thapala2301/SummerProjectMathsAccelerator/misc/Report_Sources/chapters/OrigSta_Copyright.tex

%%%%%%%%%%%%%%%%%%%%%%%%%%%%%%%%%%%%%%%
% DO NOT MODIFY FROM HERE ...
\clearpage\phantomsection
\addcontentsline{toc}{chapter}{Declaration of Originality}\mtcaddchapter 
\chapter*{Declaration of Originality}
\addtocounter{counter}{-1}
% ... TO HERE
%%%%%%%%%%%%%%%%%%%%%%%%%%%%%%%%%%%%%%%

% EDIT FROM HERE
% Example text

We hereby declare that the work presented in this lab report is our own unless otherwise stated. To the best of our knowledge the work is original and ideas developed in collaboration with others have been appropriately referenced.

\vspace{\fill} % Dynamically pushes the image block to the very bottom of the page

\begin{center}
    \vspace{-10pt} % Pulls the image box up closer to the text to save space
    
    % Shrunk to 0.48 of text width so it is guaranteed to fit on this page
    
    
    \vspace{-5pt} % Keeps the caption close to the rotated image border
    \small
    \color{gray}
    Figure 1.1: Complete real-time user interface operating on the display.
\end{center}
