thapala2301/SummerProjectMathsAccelerator/misc/Mandelbox Math.pptx

## Mandelbox Math

Dk why I made this into a presentation lmao

## Slide 2

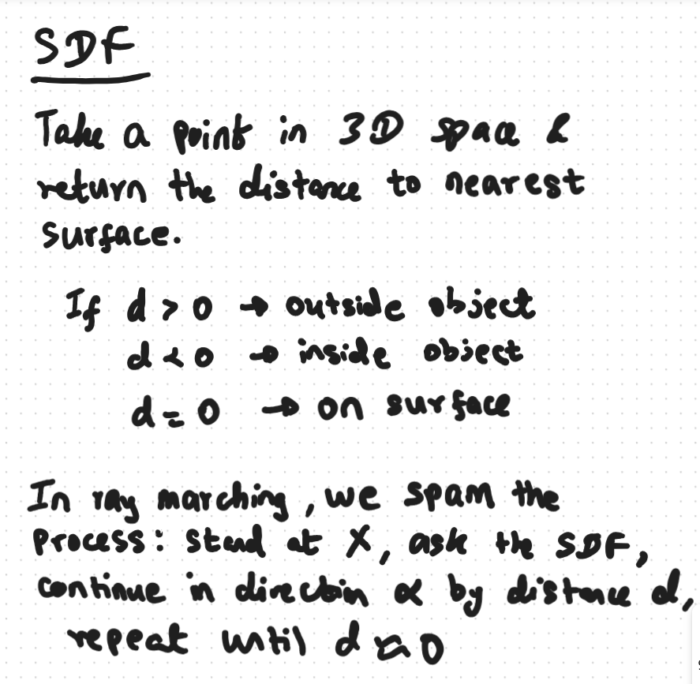
[picture p52: figure]

Example:
So like, let`s say we are looking through a pixel Y and there is a box point 10 metres ahead. There is also a box point 3 metres to the left. The distance function would say: 3 metres because that is the nearest surface in any direction. So, we would jump 3 metres in our predetermined direction and then ask again till we hit something or accept the miss after N iterations or sumn.

## Slide 3

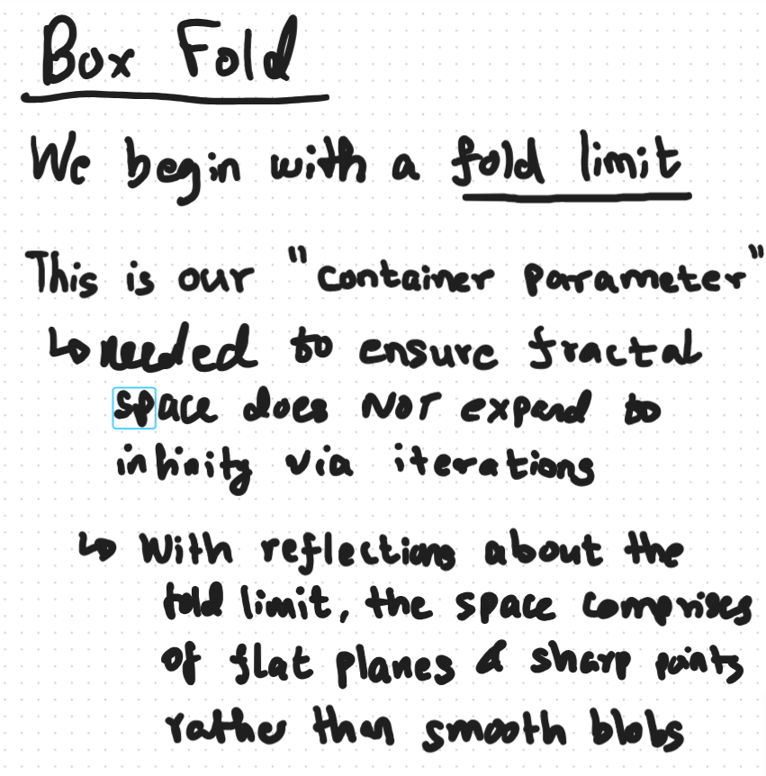
[picture p53: figure]
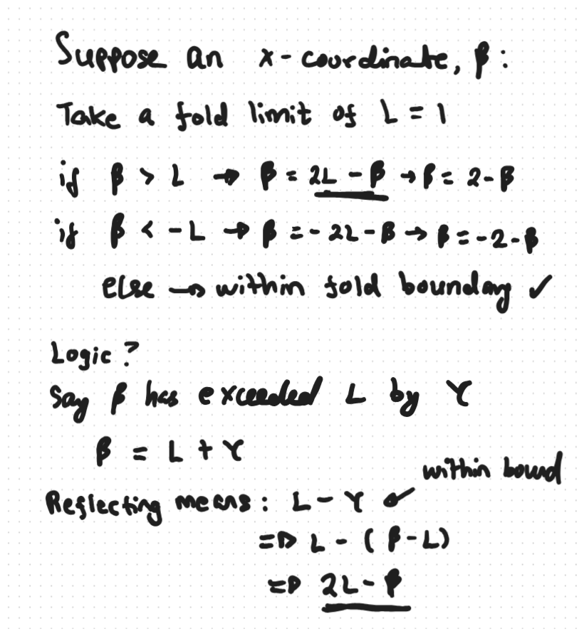
[picture p54: figure]

## Slide 4

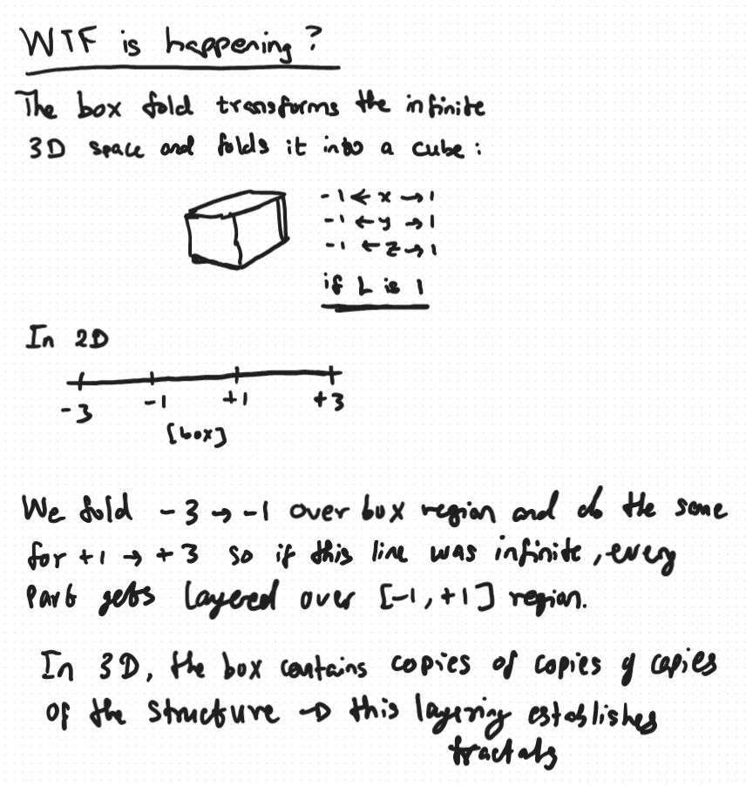
[picture p55: figure]
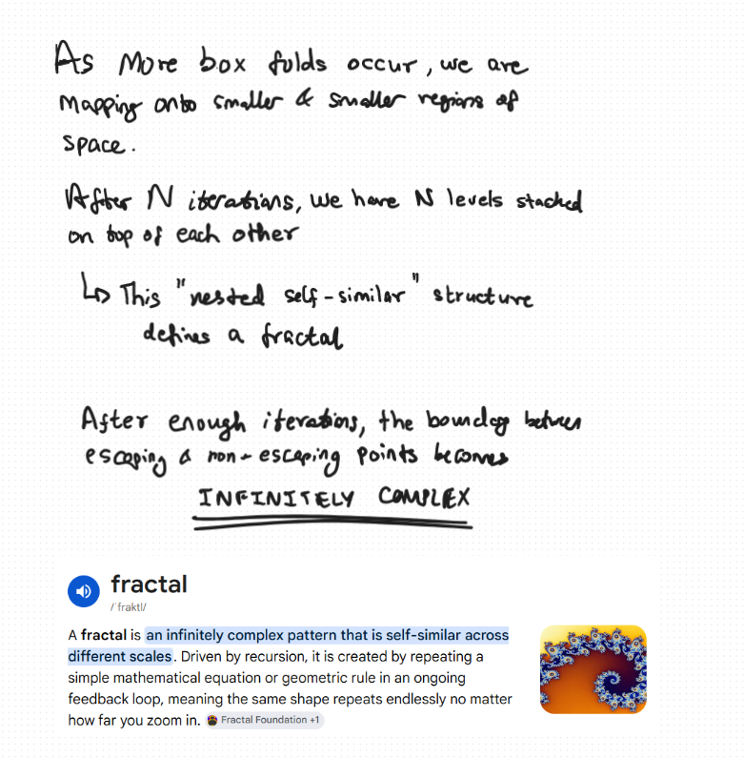
[picture p56: figure]

## Example

p = (1.7, -1.3, 0.5)
x: 1.7 > 1 → x = 2 - 1.7 = 0.3
y: -1.3 < -1 → y = -2 - (-1.3) = -2 + 1.3 = -0.7
z: in range → z = 0.5
after box fold: p = (0.3, -0.7, 0.5)

## Slide 6

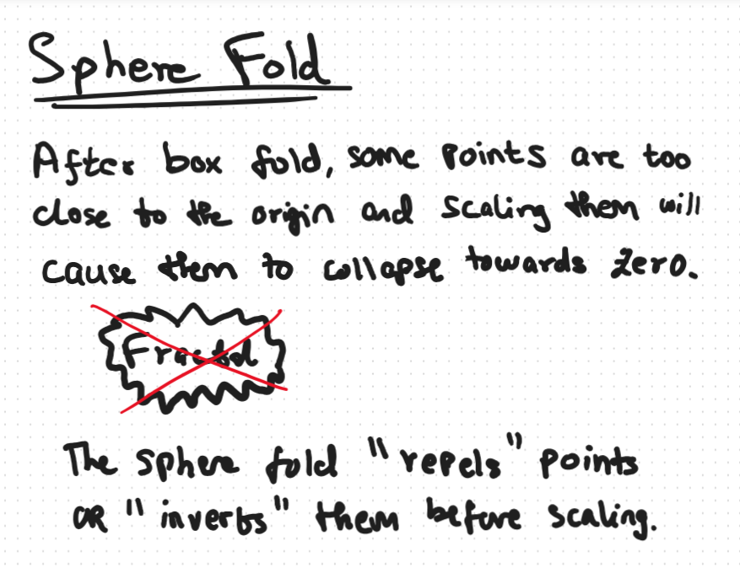
[picture p57: figure]
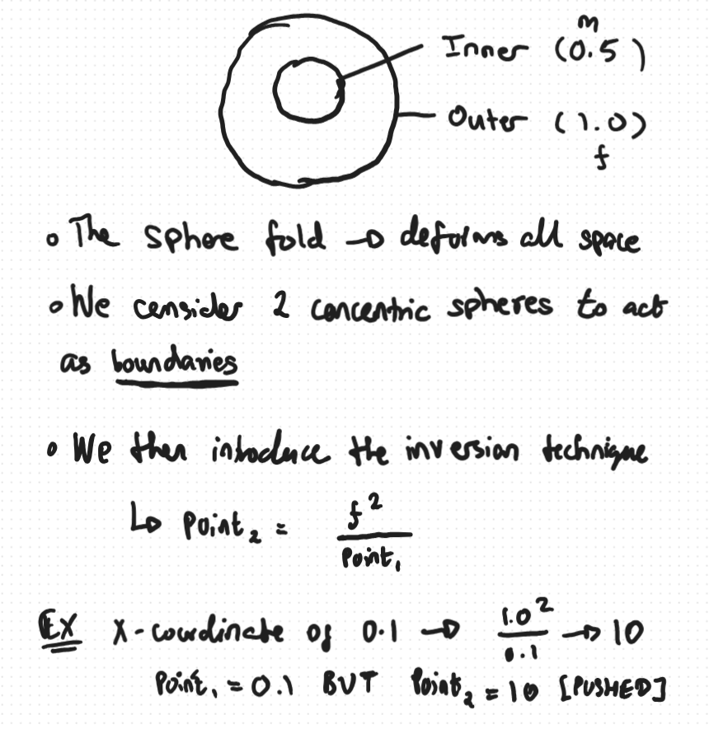
[picture p58: figure]

## Slide 7

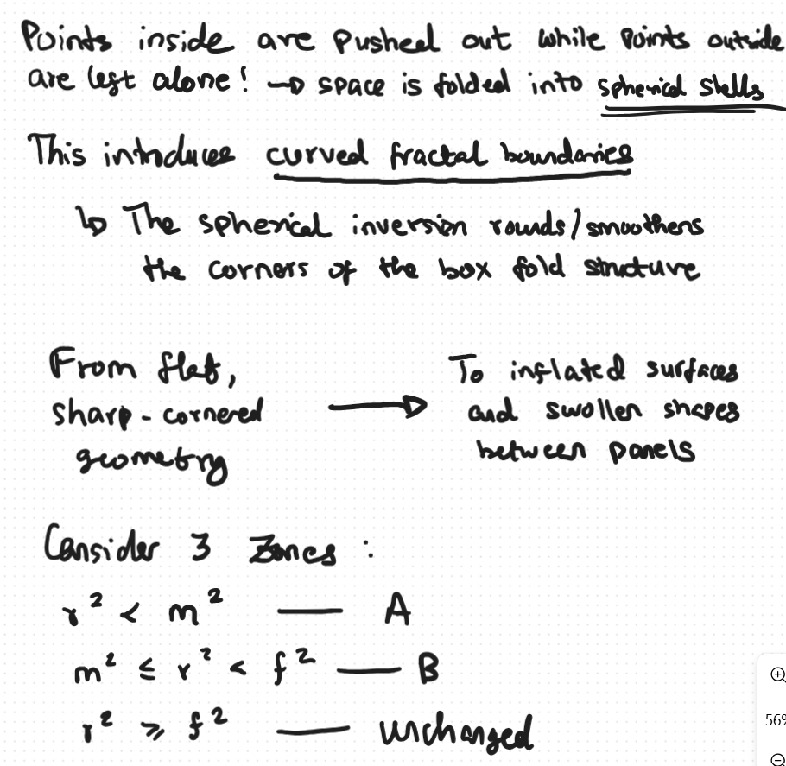
[picture p59: figure]
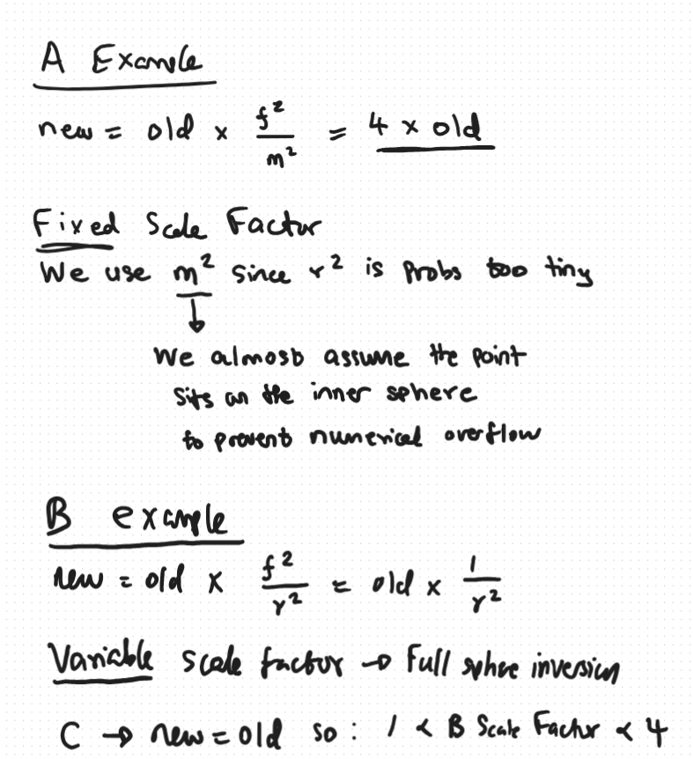
[picture p60: figure]

## Slide 8

Together they produce a structure with both cubic large-scale symmetry AND spherical fine-scale curvature. This is what gives the Mandelbox its distinctive appearance — it looks like a cubic arrangement of rounded, organic shapes.
The key interaction: with l = 1.0 and f = 1.0, the sphere fold boundary at r = 1.0 matches the box fold boundary. Points at the corners of the box (distance sqrt(3) ≈ 1.73 from origin) are outside the sphere — they pass through Zone 3 unchanged.
Points closer to the faces of the box (distance ≈ 1.0) are right on the sphere boundary. This creates the smooth rounded appearance at the corners and edges of the Mandelbox.

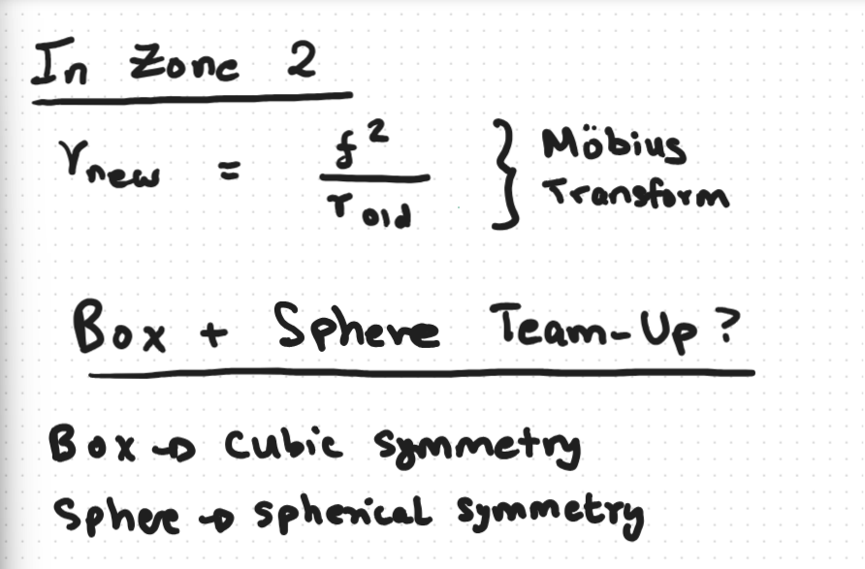
[picture p61: figure]

## Slide 9

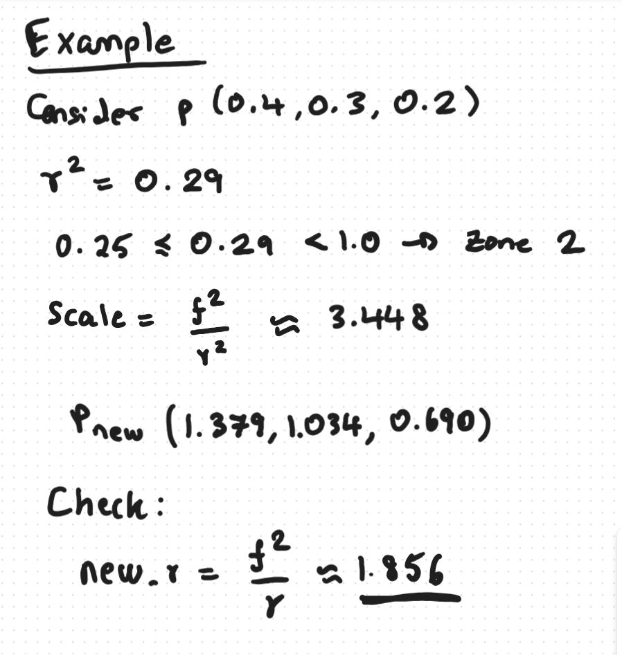
[picture p62: figure]

## Slide 10

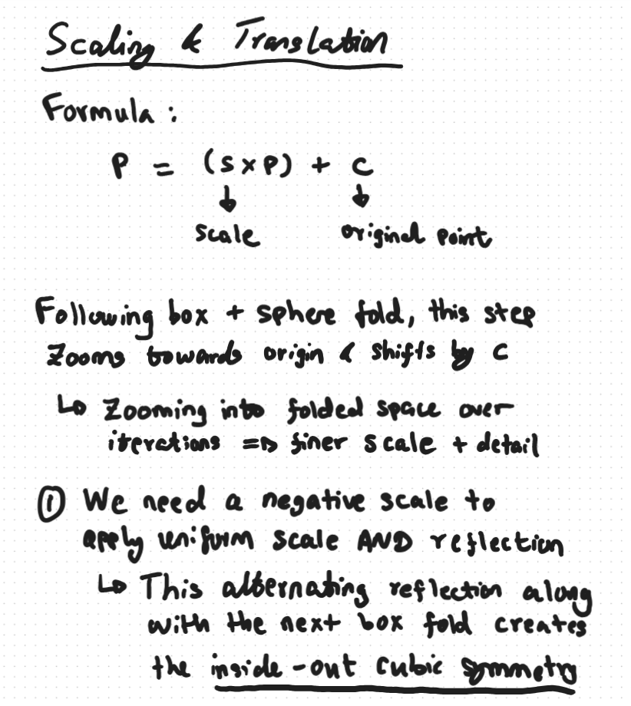
[picture p63: figure]
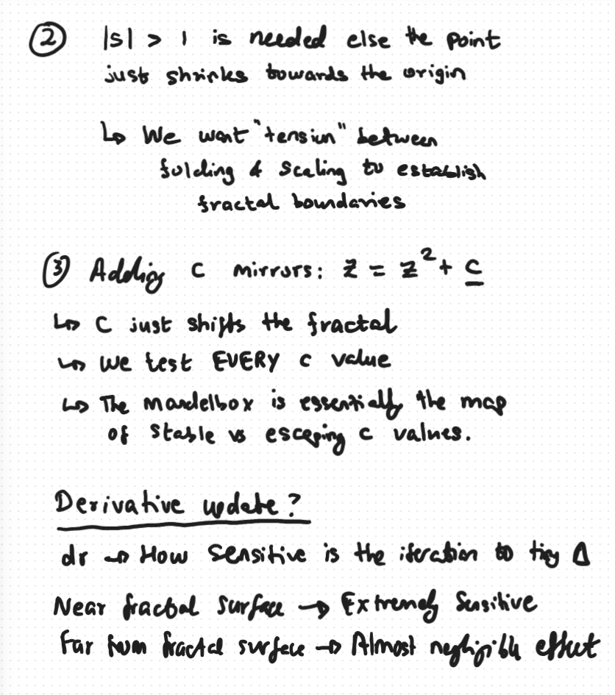
[picture p64: figure]

## Slide 11

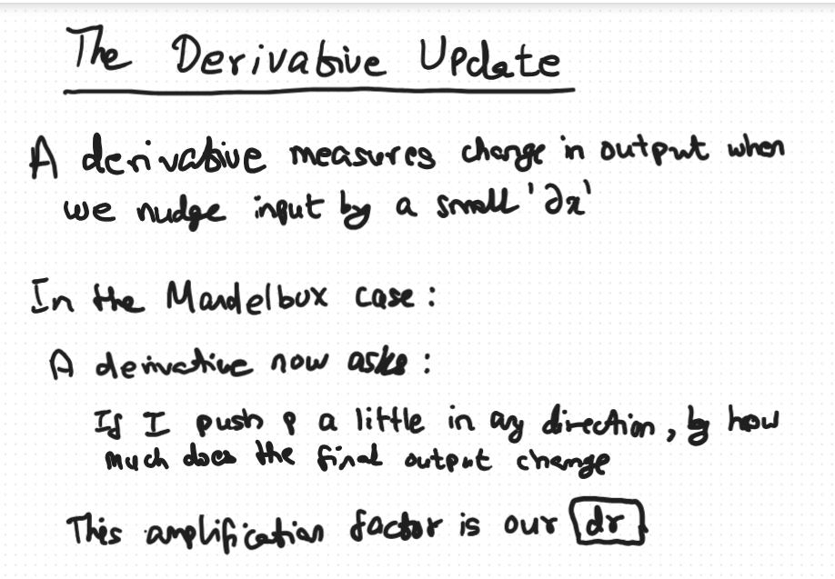
[picture p65: figure]

## Slide 12

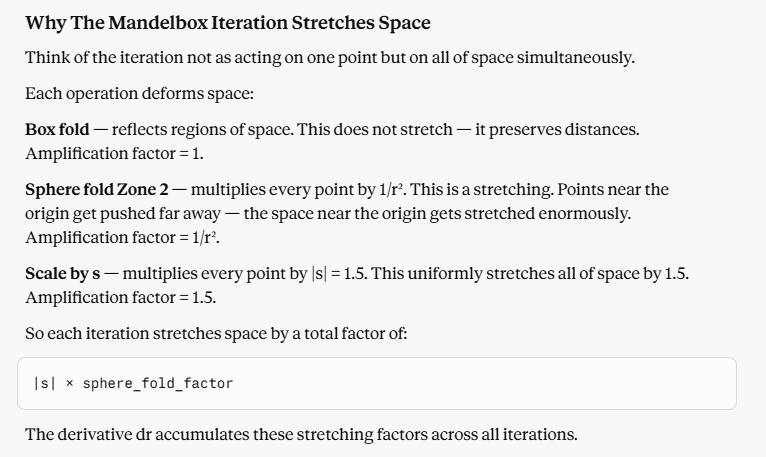
[picture p66: figure]

## Slide 13

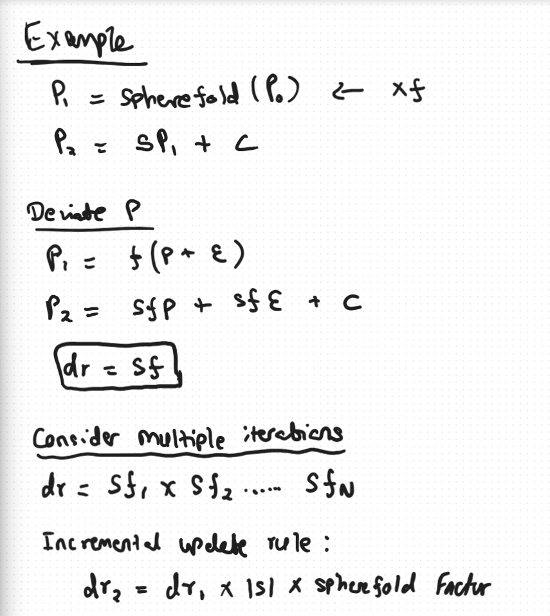
[picture p67: figure]
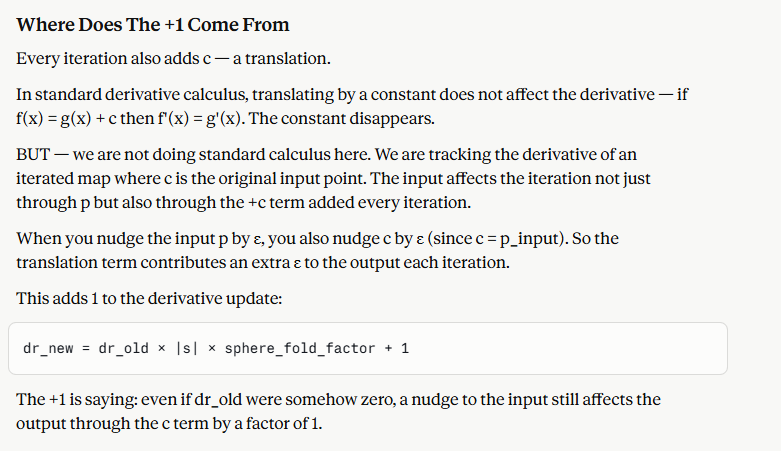
[picture p68: figure]

## Slide 14

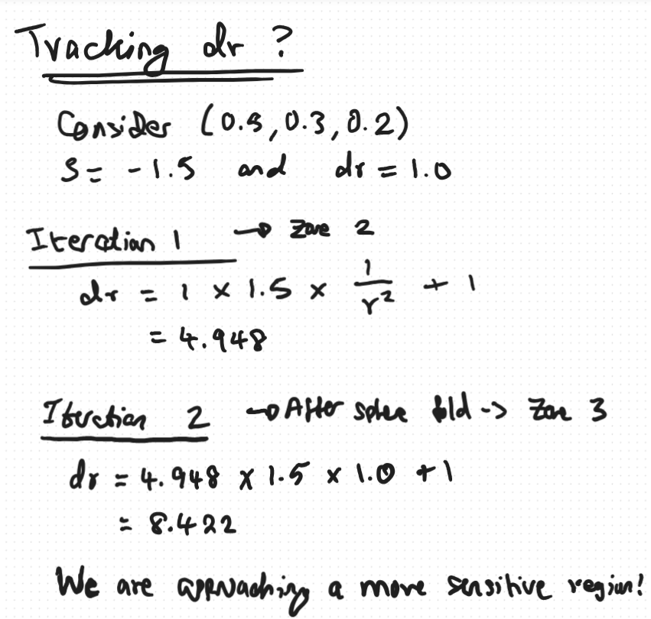
[picture p69: figure]

## Slide 15

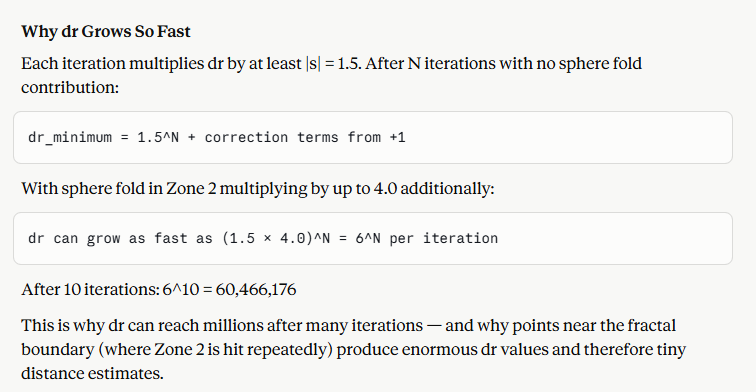
[picture p70: figure]

## Slide 16

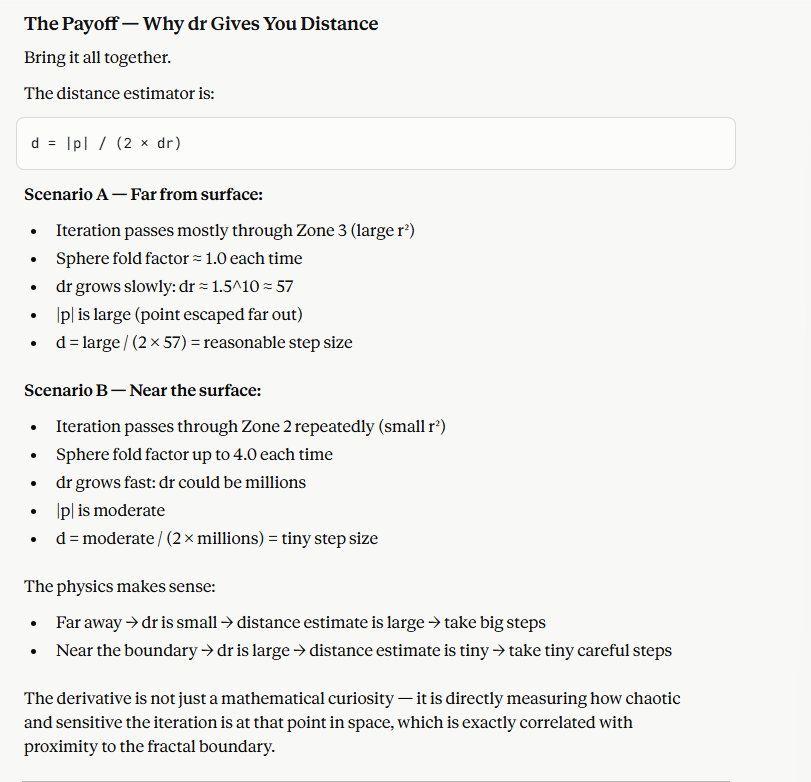
[picture p71: figure]

## Slide 17

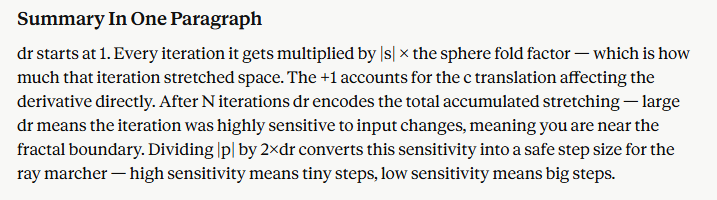
[picture p72: figure]

## Slide 18

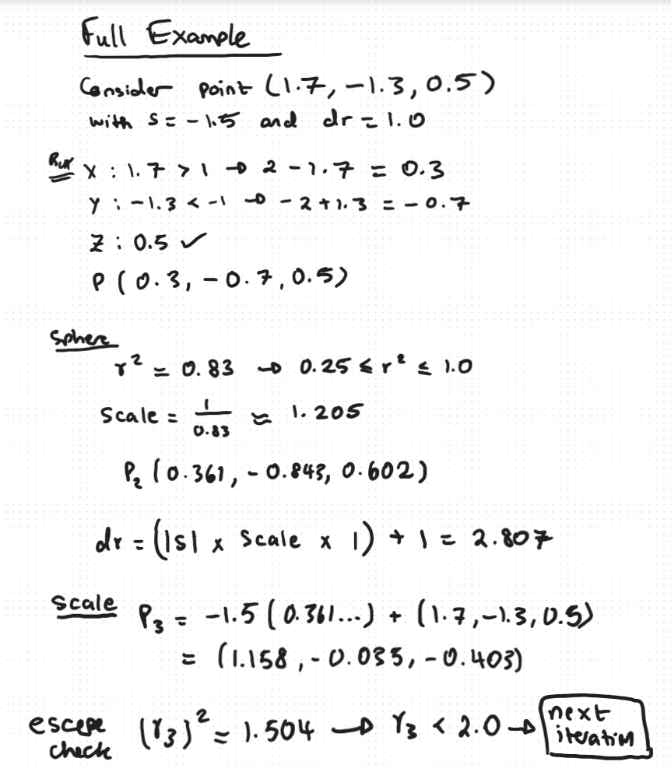
[picture p73: figure]

- Escaping Points (The Outside/Exterior): Points whose values eventually explode toward infinity. These are colored based on how quickly they escaped (their escape velocity), resulting in colorful gradients.
- Trapped Points (The Inside/Set): Points that do not diverge. Their coordinates fold and bounce around a confined space without ever leaving the boundary

## Slide 19

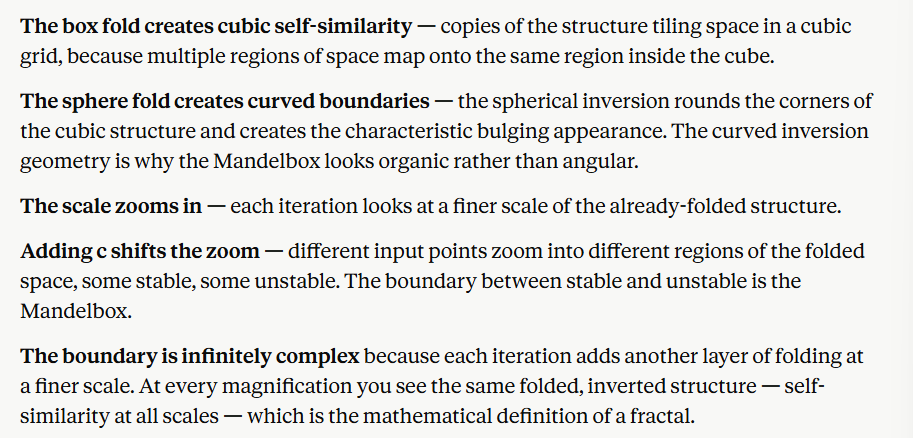
[picture p74: figure]

## Slide 20

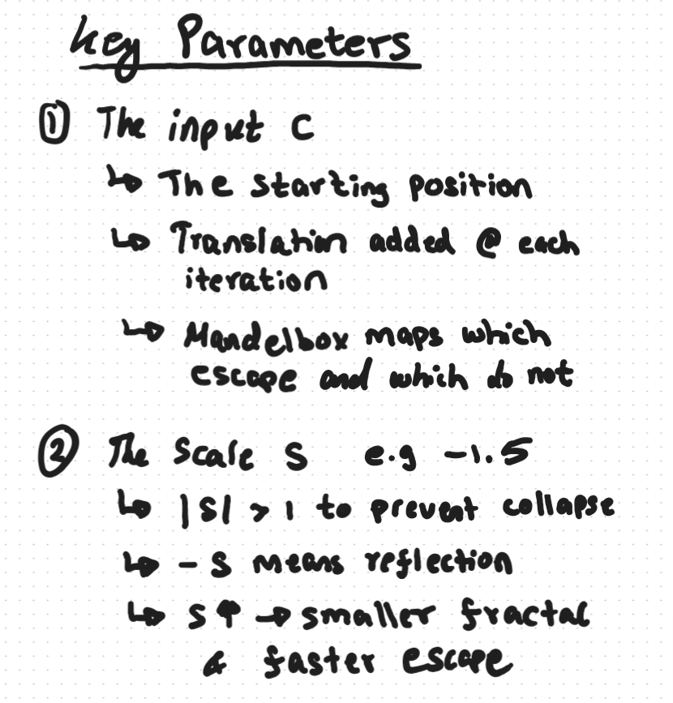
[picture p75: figure]
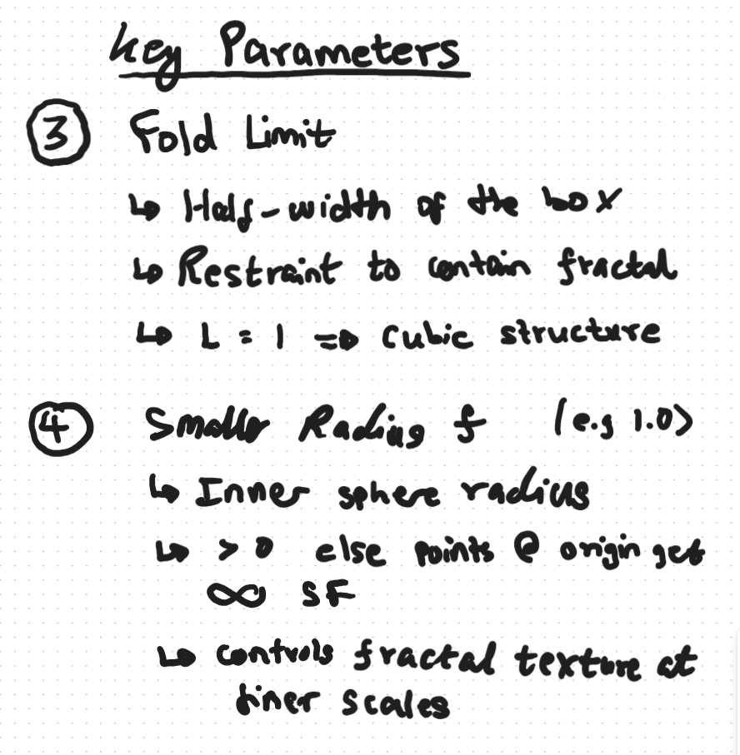
[picture p76: figure]

## Slide 21

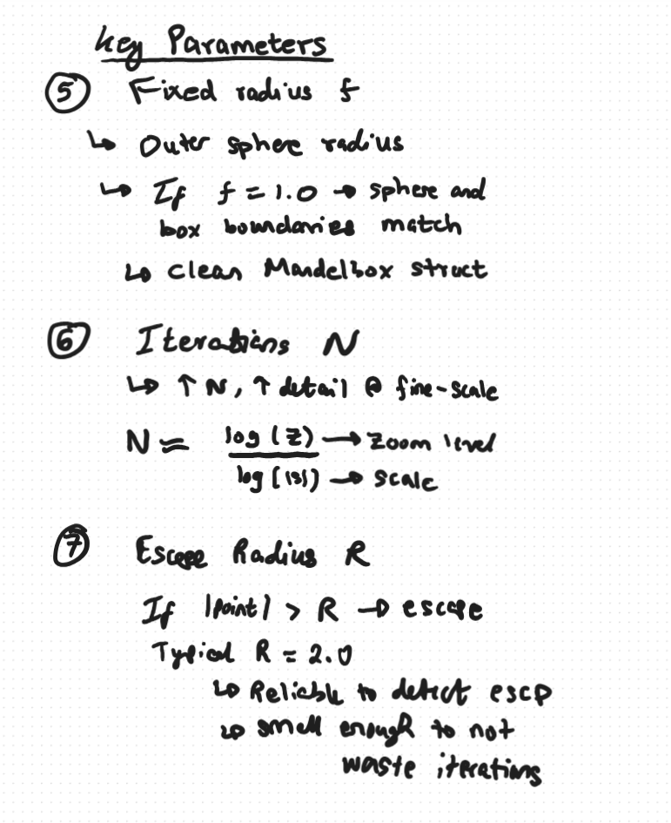
[picture p77: figure]

## Slide 22

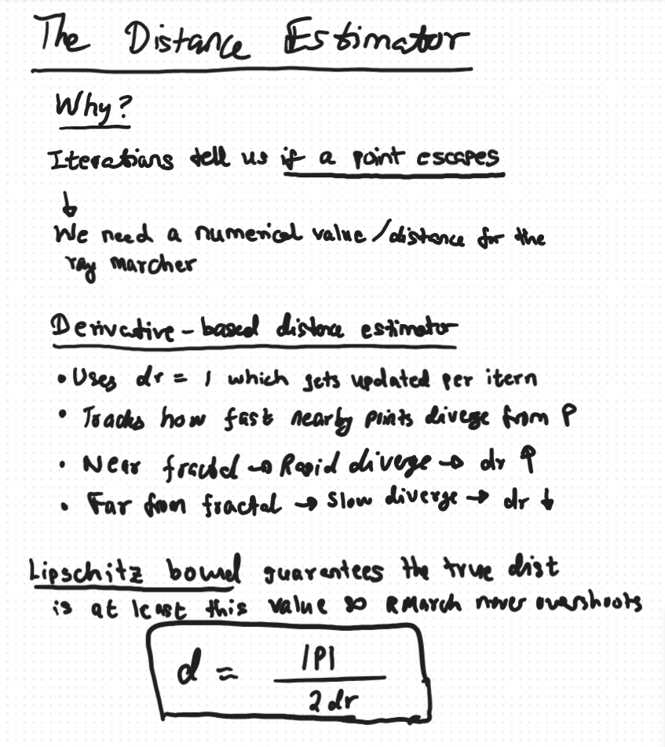
[picture p78: figure]

## Worked Example

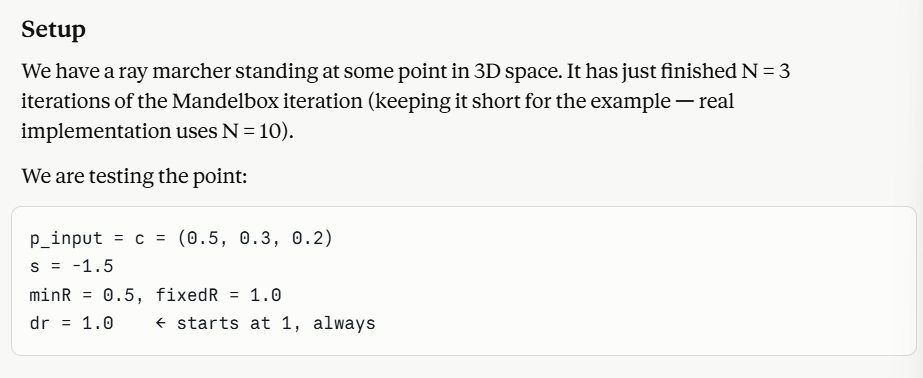
[picture p79: figure]

## Slide 24

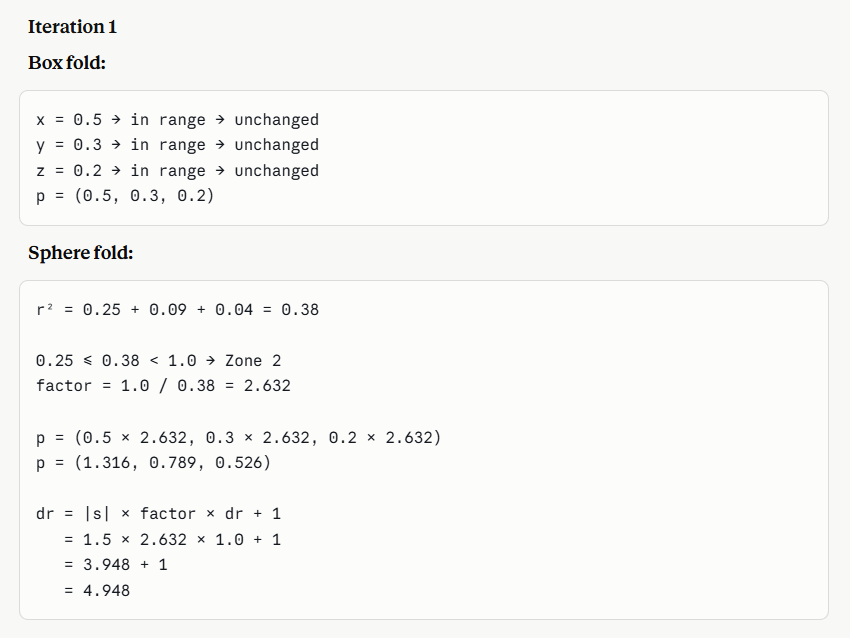
[picture p80: figure]
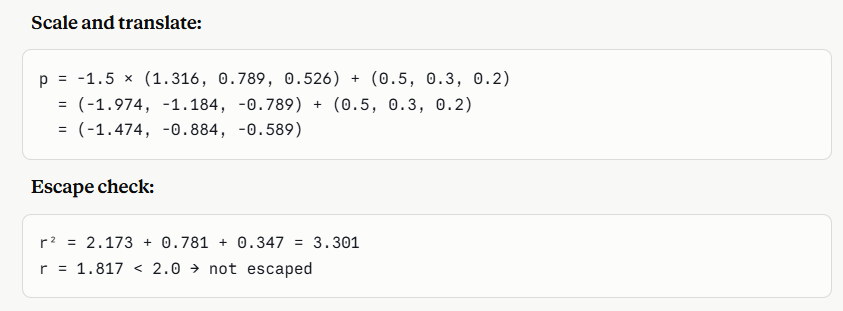
[picture p81: figure]

## Slide 25

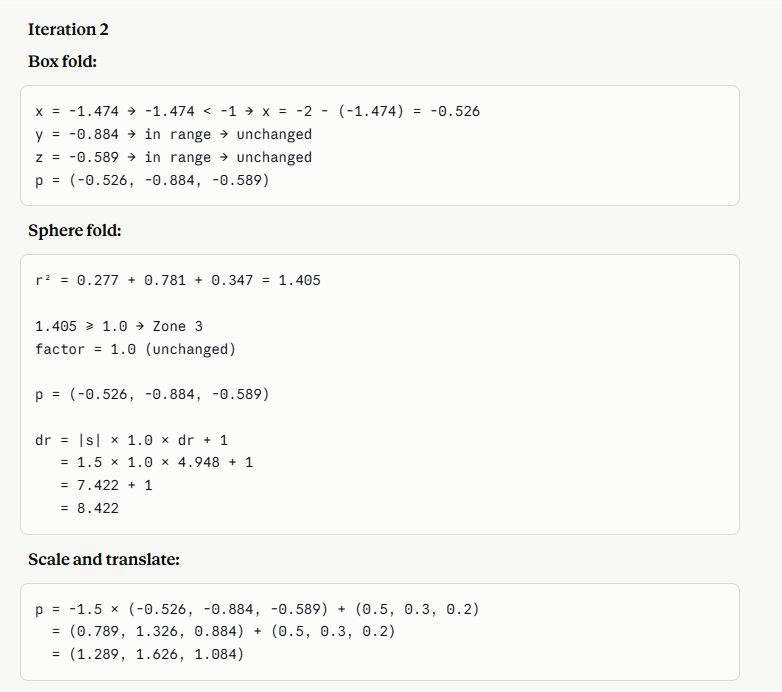
[picture p82: figure]

r² = 1.662 + 2.644 + 1.175 = 5.481
r = 2.341 > 2.0 → ESCAPED at iteration 2

## Slide 26

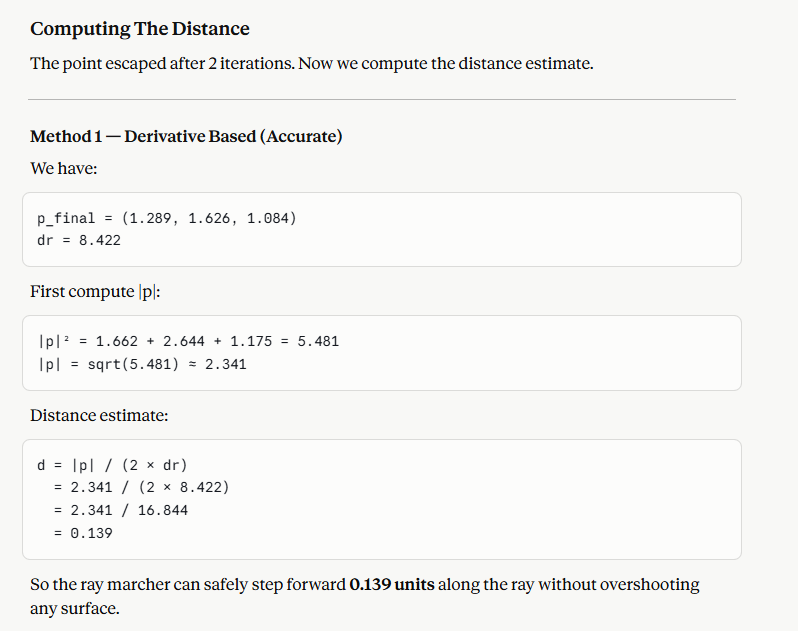
[picture p83: figure]

## Why The Derivative Method Gives A Smaller (Safer) Distance

- The derivative method accounts for the actual stretching that happened during iteration. In our example dr = 8.422 — space was stretched significantly. That means we are likely close to the fractal boundary — the large dr is a warning to be cautious — so the distance estimate comes out smaller and more conservative.
- The constant method ignores this and just uses a fixed denominator. It is less sensitive to how chaotic the iteration was.

## Slide 28

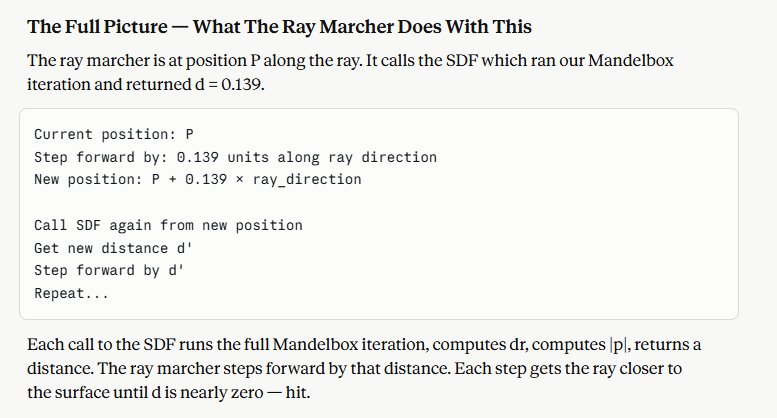
[picture p84: figure]
