thapala2301/SummerProjectMathsAccelerator/misc/Report_Sources/IMG_1227.jpg

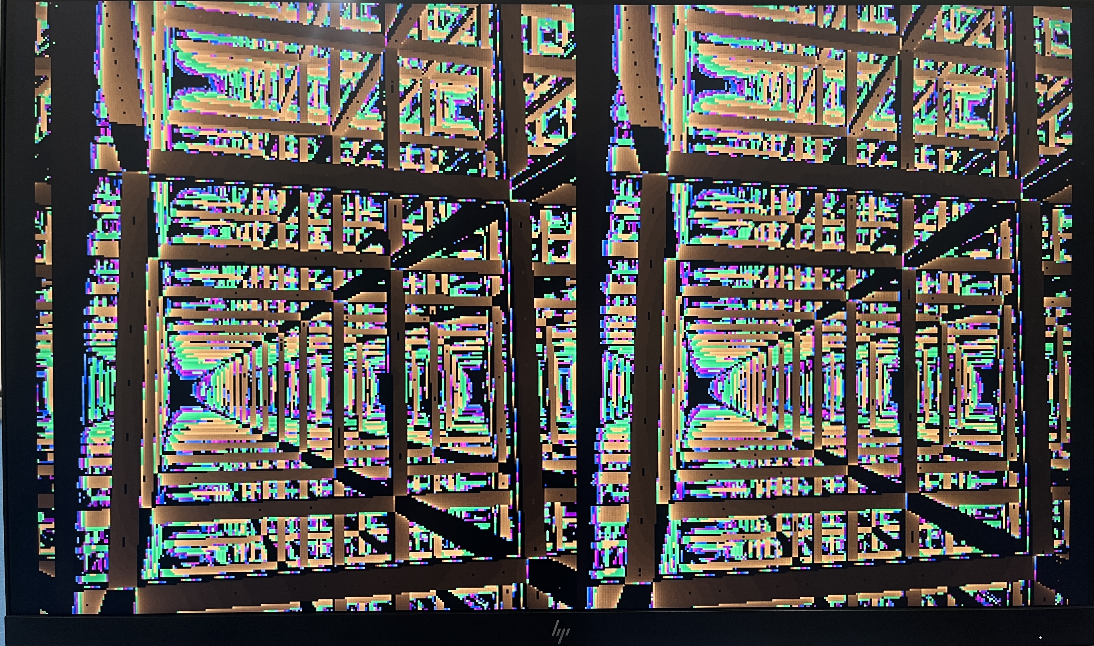
misc/Report_Sources/IMG_1227.jpg
