thapala2301/SummerProjectMathsAccelerator/misc/Report_Sources/imgs/AppendixA/mandelbox.jpeg

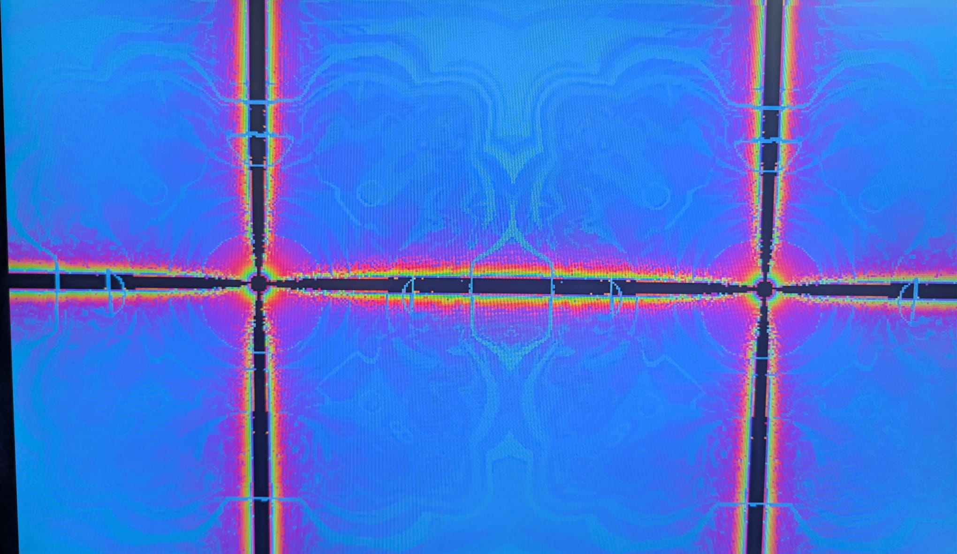
misc/Report_Sources/imgs/AppendixA/mandelbox.jpeg
