thapala2301/SummerProjectMathsAccelerator/misc/Report_Sources/imgs/initial_mandelbox.jpg

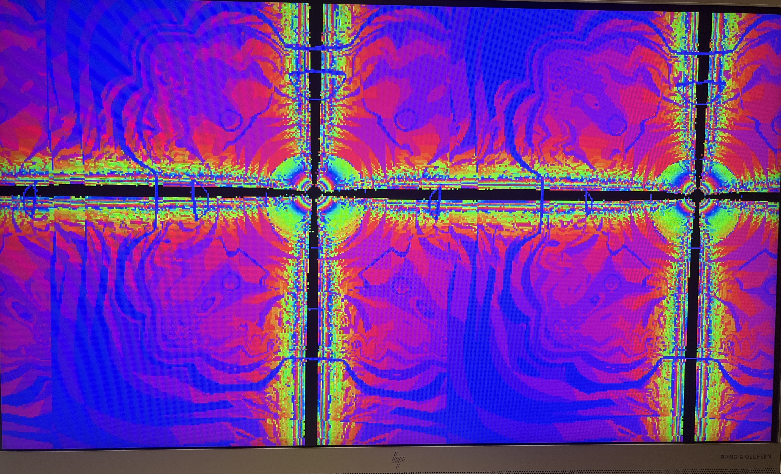
misc/Report_Sources/imgs/initial_mandelbox.jpg
