thapala2301/SummerProjectMathsAccelerator/misc/Report_Sources/imgs/Project Management/NotionSchedule.png

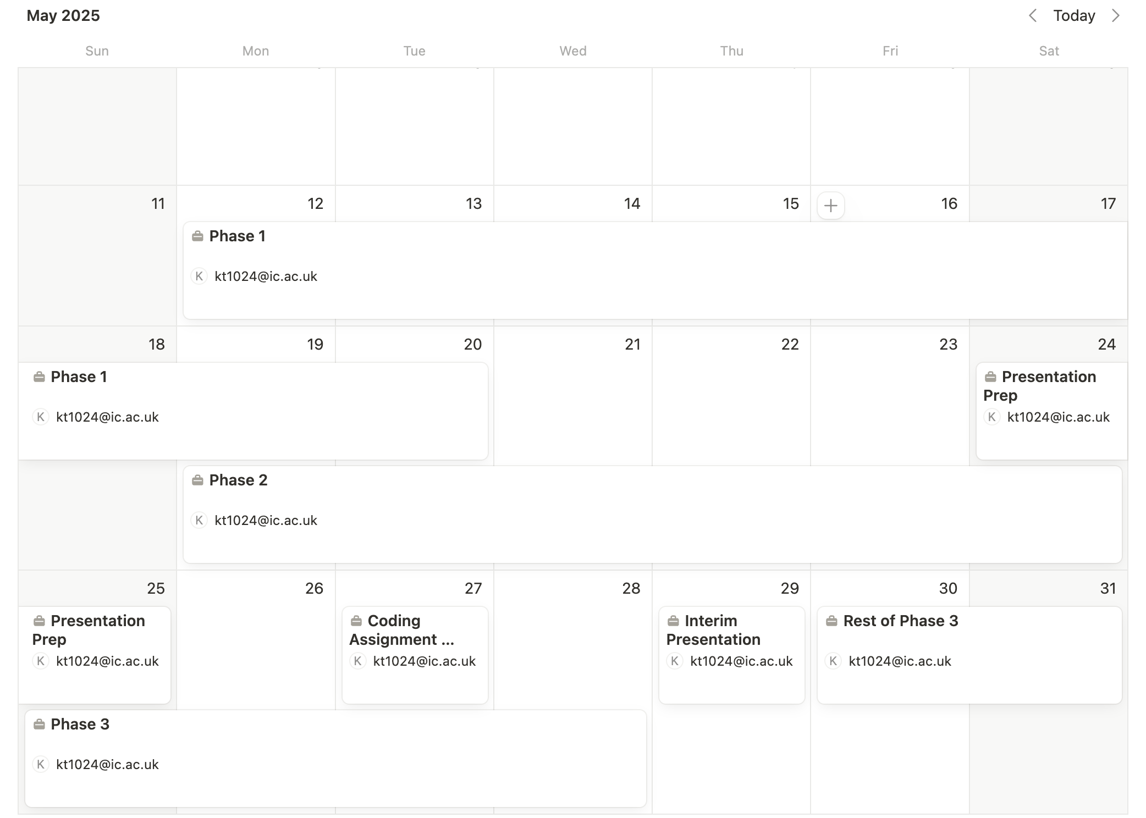
misc/Report_Sources/imgs/Project Management/NotionSchedule.png
