thapala2301/SummerProjectMathsAccelerator/misc/Report_Sources/imgs/sphere_sdf_infinite.jpg

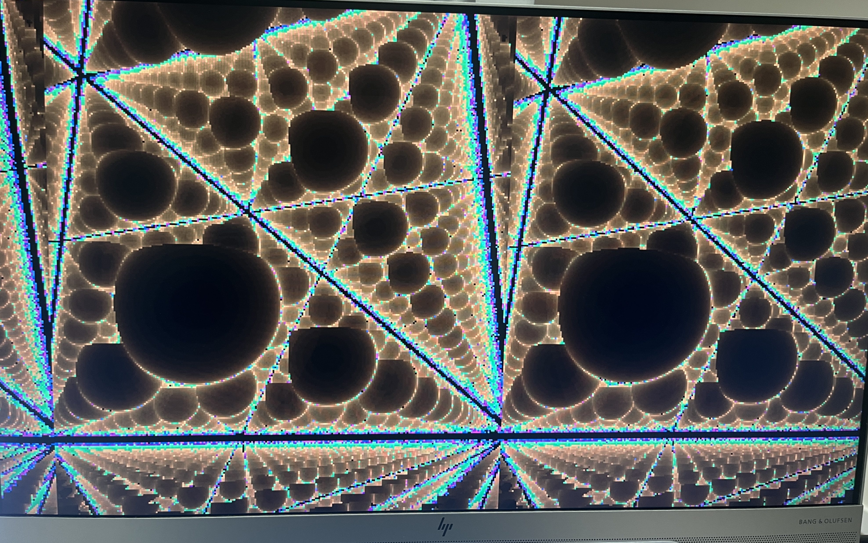
misc/Report_Sources/imgs/sphere_sdf_infinite.jpg
