thapala2301/SummerProjectMathsAccelerator/SCRIPTS/PYNQ/base_ui.png

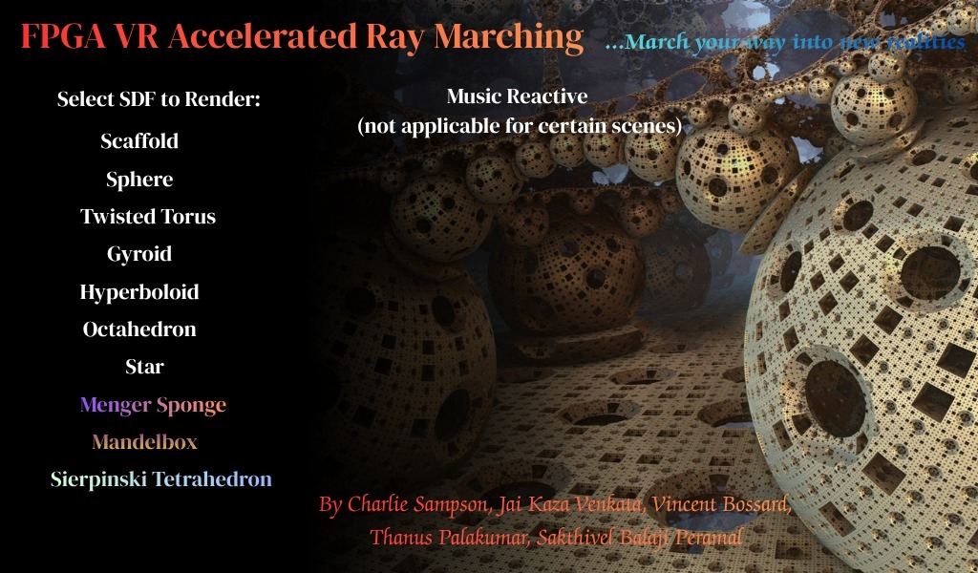
SCRIPTS/PYNQ/base_ui.png
