thapala2301/SummerProjectMathsAccelerator/VDMA_MulticoreSummerProjectMathsAccelerator copy/Geralt_fft/docs/PYNQ FFT/FFT_TOP.png

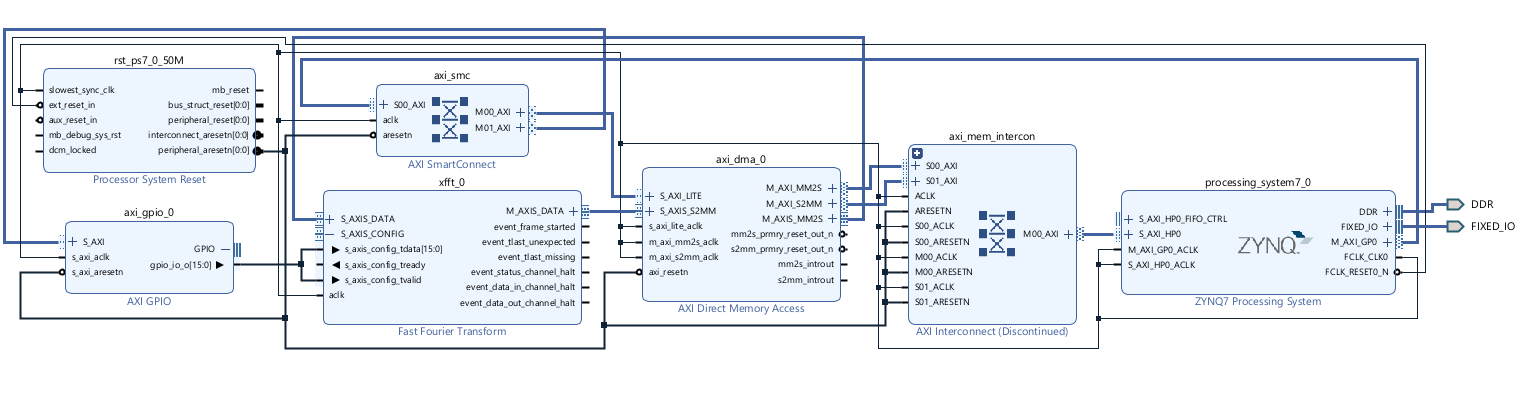
VDMA_MulticoreSummerProjectMathsAccelerator copy/Geralt_fft/docs/PYNQ FFT/FFT_TOP.png
