thapala2301/SummerProjectMathsAccelerator/VDMA_MulticoreSummerProjectMathsAccelerator copy/Geralt_fft/docs/PYNQ FFT/vivado_waveform.png

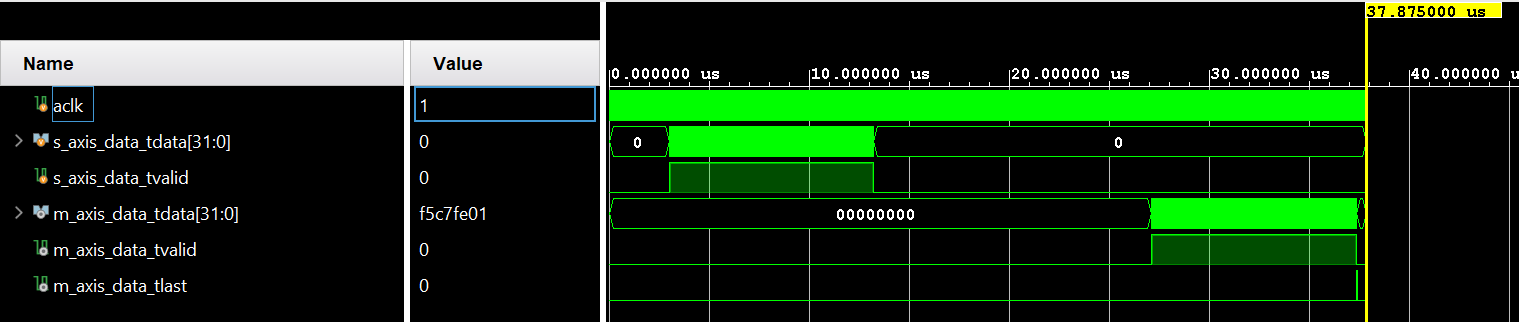
VDMA_MulticoreSummerProjectMathsAccelerator copy/Geralt_fft/docs/PYNQ FFT/vivado_waveform.png
