thapala2301/SummerProjectMathsAccelerator/CAD/BodyAdapted.SLDASM

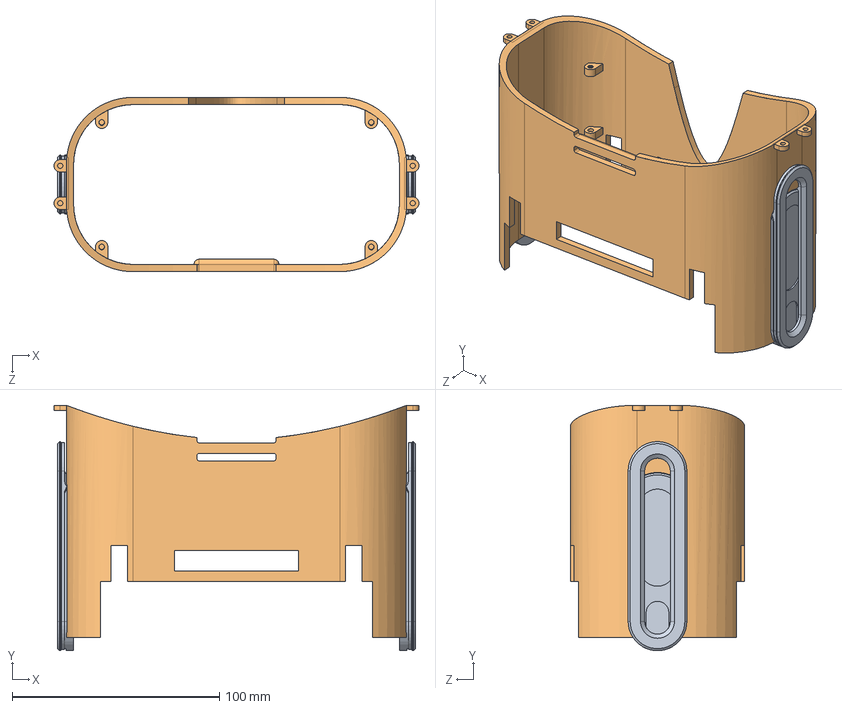
[picture p94: CAD file, 2026-06-28]
CAD/BodyAdapted.SLDASM
176.0 x 118.3 x 84.0 mm
Quest2Adapter x 2
