thapala2301/SummerProjectMathsAccelerator/CAD/mechanic(2).SLDASM

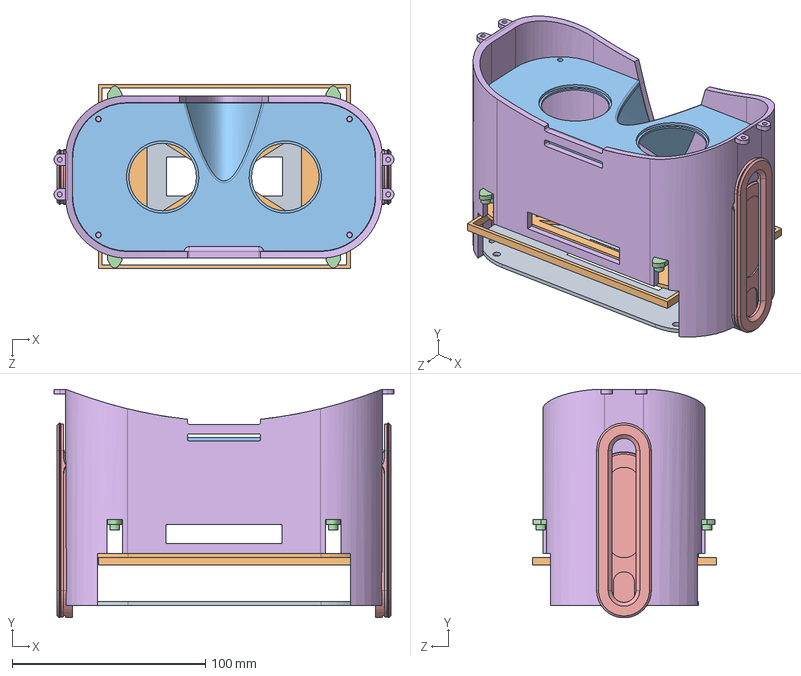
[picture p95: CAD file, 2026-06-28]
CAD/mechanic(2).SLDASM
176.0 x 118.3 x 95.5 mm
Quest2Adapter x 2
screen_panel
eyes_panel
front_panel
most_front_panel
