thapala2301/SummerProjectMathsAccelerator/CAD/most_front_panel.SLDPRT

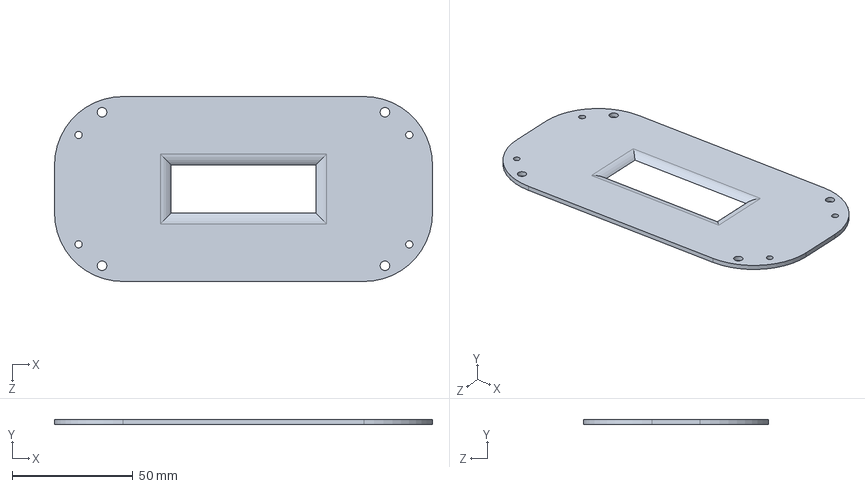
[picture p96: CAD file, 2026-06-28]
CAD/most_front_panel.SLDPRT
156.6 x 2.00 x 76.6 mm
