thapala2301/SummerProjectMathsAccelerator/Neural_SDF_Research/Software_Neural/stanford-bunny.obj

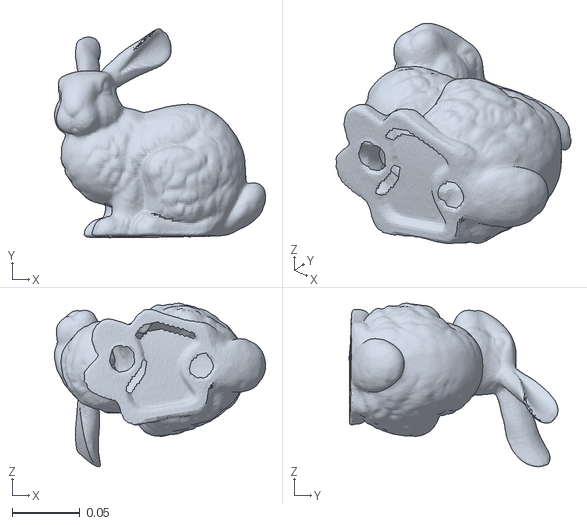
[picture p97: CAD file, 2026-06-28]
Neural_SDF_Research/Software_Neural/stanford-bunny.obj
0.156 x 0.154 x 0.121
