thapala2301/SummerProjectMathsAccelerator/CAD/Quest2Adapter.SLDPRT

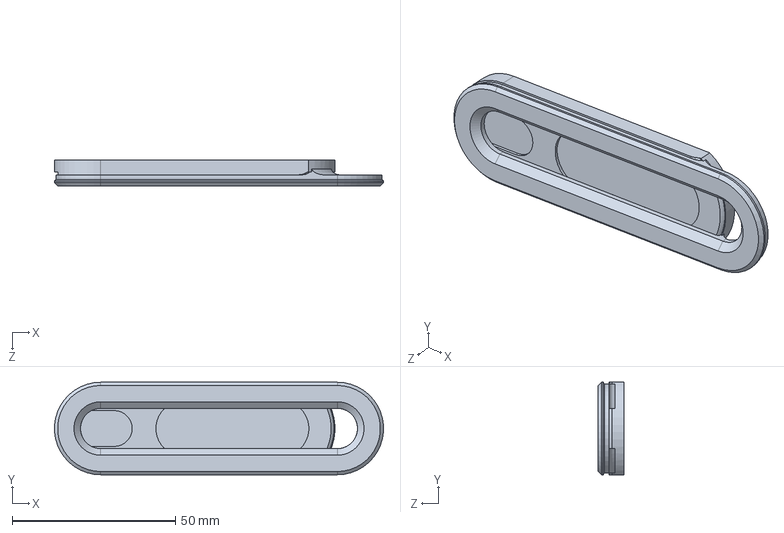
[picture p98: CAD file, 2026-06-28]
CAD/Quest2Adapter.SLDPRT
100.8 x 28.3 x 7.83 mm
