thapala2301/SummerProjectMathsAccelerator/CAD/Quest 3 Head band adapter v5.SLDPRT

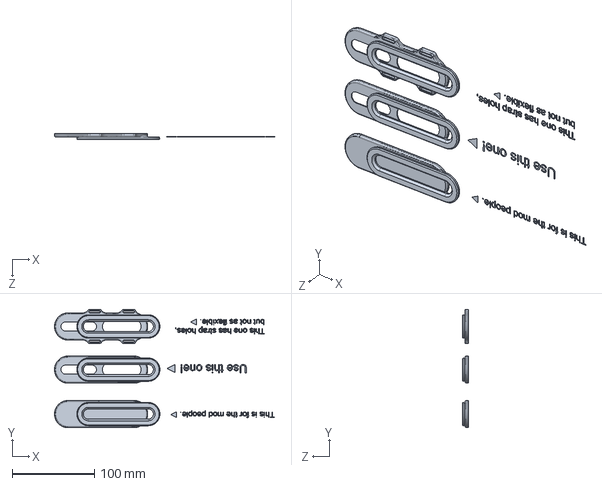
[picture p99: CAD file, 2026-06-28]
CAD/Quest 3 Head band adapter v5.SLDPRT
266.8 x 143.5 x 7.83 mm
