thapala2301/SummerProjectMathsAccelerator/CAD/front_panel.SLDPRT

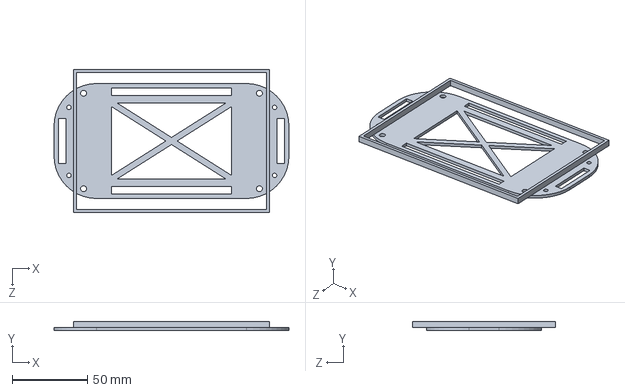
[picture p100: CAD file, 2026-06-28]
CAD/front_panel.SLDPRT
156.6 x 6.00 x 95.5 mm
