thapala2301/SummerProjectMathsAccelerator/CAD/eyes_panel.SLDPRT

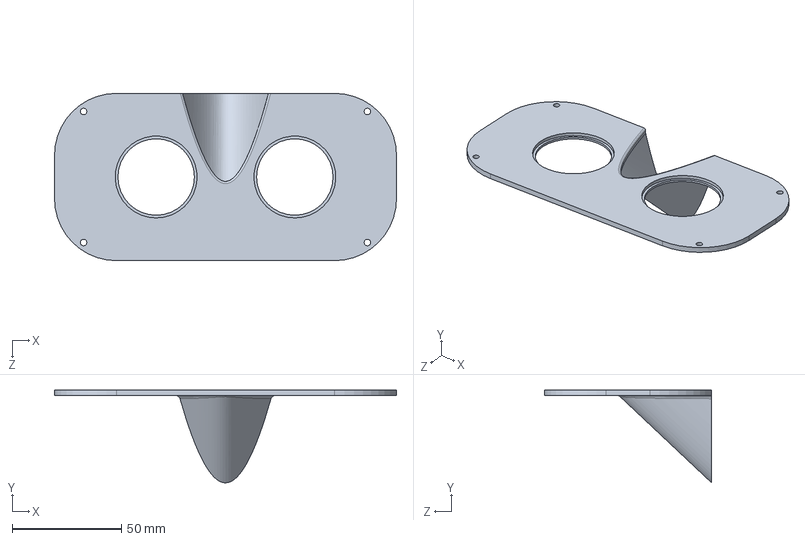
[picture p101: CAD file, 2026-06-28]
CAD/eyes_panel.SLDPRT
156.6 x 42.5 x 76.6 mm
