thapala2301/SummerProjectMathsAccelerator/CAD/body.SLDPRT

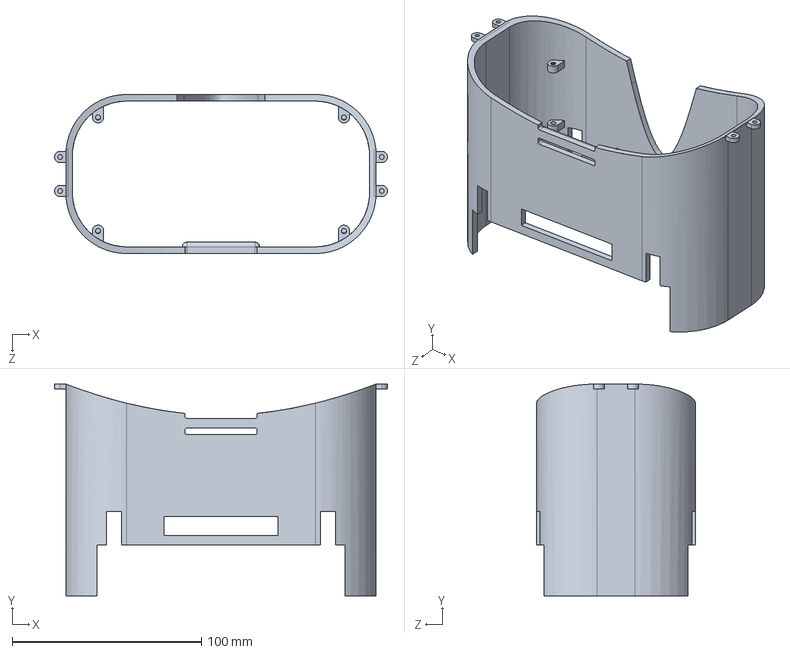
[picture p102: CAD file, 2026-06-28]
CAD/body.SLDPRT
176.0 x 112.0 x 84.0 mm
