thapala2301/SummerProjectMathsAccelerator/CAD/screen_panel.SLDPRT

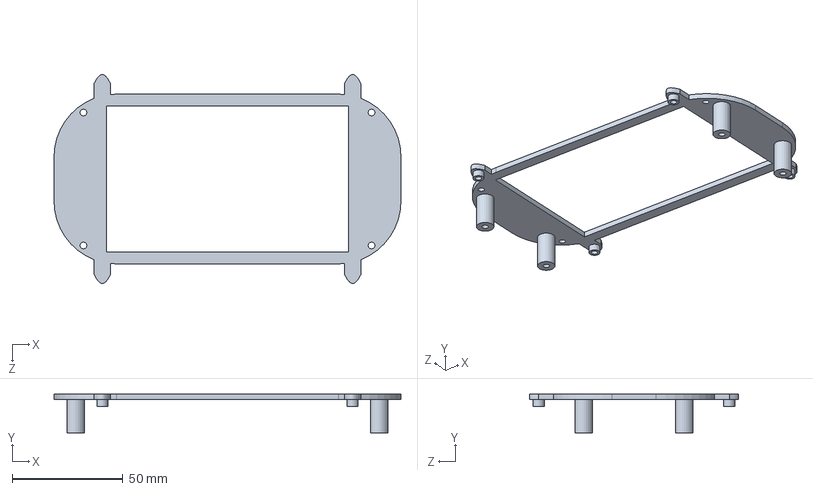
[picture p103: CAD file, 2026-06-28]
CAD/screen_panel.SLDPRT
156.6 x 17.5 x 94.2 mm
