thapala2301/SummerProjectMathsAccelerator/(list of files, cad)

Other CAD files:
CAD/foam_support.SLDPRT
