thapala2301/SummerProjectMathsAccelerator/SIM_testbenches/menger_rtl.png

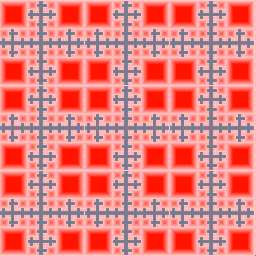
SIM_testbenches/menger_rtl.png
