thapala2301/SummerProjectMathsAccelerator/misc/progress_log.txt

Progress Log.
01/06/26: Core Ray Marcher functionally working, started 5 days ago
