thapala2301/SummerProjectMathsAccelerator/RTL/core/march_core.sv

module march_core(
    input  logic        clk,
    input  logic        rst_n,
    input  logic [10:0] in_x,
    input  logic [9:0]  in_y,
    input  logic [19:0] in_pix_id,
    input  logic [26:0] in_pos_x,
    input  logic [26:0] in_pos_y,
    input  logic [26:0] in_pos_z,
    input  logic [26:0] in_ray_dir_x,
    input  logic [26:0] in_ray_dir_y,
    input  logic [26:0] in_ray_dir_z,
    input  logic [7:0]  in_iter,
    input  logic        in_valid,
    input  logic [26:0] lookat [0:8],
    input  logic [26:0] cam_origin [0:2],
    input  logic [26:0] scene_cell_sz,
    input  logic [26:0] scene_half_cell,
    input  logic [26:0] scene_shape_size,
    input  logic [26:0] scene_shape_extra,
    output logic        pix_done,
    output logic [19:0] out_pix_id,
    output logic [7:0]  out_iter,
    output logic [7:0]  fb_iter,
    output logic [26:0] fb_ray_dir_x,
    output logic [26:0] fb_ray_dir_y,
    output logic [26:0] fb_ray_dir_z,
    output logic [26:0] fb_pos_x,
    output logic [26:0] fb_pos_y,
    output logic [26:0] fb_pos_z,
    output logic [19:0] fb_pix_id,
    output logic        fb_valid
);

logic [26:0] rg_dir[0:2];
logic [26:0] rg_orig[0:2];
logic [19:0] rg_pix_id;
logic        rg_valid;
logic [26:0] eye_offset[0:2];
logic [26:0] cam_origin_left[0:2];
logic [26:0] cam_origin_right[0:2];

localparam int RG_LAT = 48;
localparam int REPEAT_LAT = 64;
localparam int SCENE_CORE_LAT = 50; // sphere_sdf = 37, scaffold_sdf = 50, twisted_torus_sdf = 101
localparam int SDF_LAT = REPEAT_LAT + SCENE_CORE_LAT;
localparam int STEP_LAT = 8;
localparam int MAX_ITER = 128;
localparam [26:0] HIT_THRESH = {1'b0, 8'd117, 18'h01893};
localparam [26:0] HALF_IPD = 27'h1E7AE14;

// lookat[0:2] is the camera right vector; stereo is a parallel sideways offset.
fp_mul inst_eye_offset_x(.clk(clk), .a(lookat[0]), .b(HALF_IPD), .out(eye_offset[0]));
fp_mul inst_eye_offset_y(.clk(clk), .a(lookat[1]), .b(HALF_IPD), .out(eye_offset[1]));
fp_mul inst_eye_offset_z(.clk(clk), .a(lookat[2]), .b(HALF_IPD), .out(eye_offset[2]));

fp_sub inst_left_eye_x(.clk(clk), .a(cam_origin[0]), .b(eye_offset[0]), .out(cam_origin_left[0]));
fp_sub inst_left_eye_y(.clk(clk), .a(cam_origin[1]), .b(eye_offset[1]), .out(cam_origin_left[1]));
fp_sub inst_left_eye_z(.clk(clk), .a(cam_origin[2]), .b(eye_offset[2]), .out(cam_origin_left[2]));

fp_add inst_right_eye_x(.clk(clk), .a(cam_origin[0]), .b(eye_offset[0]), .out(cam_origin_right[0]));
fp_add inst_right_eye_y(.clk(clk), .a(cam_origin[1]), .b(eye_offset[1]), .out(cam_origin_right[1]));
fp_add inst_right_eye_z(.clk(clk), .a(cam_origin[2]), .b(eye_offset[2]), .out(cam_origin_right[2]));

ray_gen #(
    .IMG_W(512),
    .IMG_H(600),
    .FOV_Z_CONST(27'h220DF14)
) inst1_ray_gen(
    .clk(clk),
    .rst_n(rst_n),
    .pix_x(in_x),
    .pix_y(in_y),
    .pix_id_in(in_pix_id),
    .valid_in(in_valid),
    .lookat(lookat),
    .cam_origin_left(cam_origin_left),
    .cam_origin_right(cam_origin_right),
    .valid_out(rg_valid),
    .ray_dir(rg_dir),
    .ray_orig(rg_orig),
    .pix_id_out(rg_pix_id),
    .pipeline_ready()
);

logic [26:0] d1_pos_x;
logic [26:0] d1_pos_y;
logic [26:0] d1_pos_z;
logic [26:0] d1_dir_x;
logic [26:0] d1_dir_y;
logic [26:0] d1_dir_z;
logic [7:0]  d1_iter;
logic [19:0] d1_pix_id;
logic        d1_valid;
logic [26:0] s1_pos_x;
logic [26:0] s1_pos_y;
logic [26:0] s1_pos_z;
logic [26:0] s1_dir_x;
logic [26:0] s1_dir_y;
logic [26:0] s1_dir_z;
logic [26:0] s1_scene_pos_x;
logic [26:0] s1_scene_pos_y;
logic [26:0] s1_scene_pos_z;
logic [7:0]  s1_iter;
logic [19:0] s1_pix_id;
logic        s1_valid;
logic        s1_is_new_ray;

state_pipe #(.WIDTH(27), .DEPTH(RG_LAT)) inst1_in_pos_x(.clk(clk), .in(in_pos_x), .out(d1_pos_x));
state_pipe #(.WIDTH(27), .DEPTH(RG_LAT)) inst1_in_pos_y(.clk(clk), .in(in_pos_y), .out(d1_pos_y));
state_pipe #(.WIDTH(27), .DEPTH(RG_LAT)) inst1_in_pos_z(.clk(clk), .in(in_pos_z), .out(d1_pos_z));
state_pipe #(.WIDTH(27), .DEPTH(RG_LAT)) inst1_in_dir_x(.clk(clk), .in(in_ray_dir_x), .out(d1_dir_x));
state_pipe #(.WIDTH(27), .DEPTH(RG_LAT)) inst1_in_dir_y(.clk(clk), .in(in_ray_dir_y), .out(d1_dir_y));
state_pipe #(.WIDTH(27), .DEPTH(RG_LAT)) inst1_in_dir_z(.clk(clk), .in(in_ray_dir_z), .out(d1_dir_z));
state_pipe #(.WIDTH(8),  .DEPTH(RG_LAT)) inst1_in_iter (.clk(clk), .in(in_iter),      .out(d1_iter));
state_pipe #(.WIDTH(20), .DEPTH(RG_LAT)) inst1_in_pix_id(.clk(clk), .in(in_pix_id),    .out(d1_pix_id));
state_pipe #(.WIDTH(1),  .DEPTH(RG_LAT)) inst1_in_valid(.clk(clk), .in(in_valid),      .out(d1_valid));

//combinatorial mux select ray origin on first iteration, feedback pos otw
wire [26:0] s1_pos_x_comb = (d1_iter == 8'd0) ? rg_orig[0] : d1_pos_x;
wire [26:0] s1_pos_y_comb = (d1_iter == 8'd0) ? rg_orig[1] : d1_pos_y;
wire [26:0] s1_pos_z_comb = (d1_iter == 8'd0) ? rg_orig[2] : d1_pos_z;
wire [26:0] s1_dir_x_comb = (d1_iter == 8'd0) ? rg_dir[0]  : d1_dir_x;
wire [26:0] s1_dir_y_comb = (d1_iter == 8'd0) ? rg_dir[1]  : d1_dir_y;
wire [26:0] s1_dir_z_comb = (d1_iter == 8'd0) ? rg_dir[2]  : d1_dir_z;
wire        s1_is_new_ray_comb = (d1_iter == 8'd0);

always_ff @(posedge clk) begin
    s1_pos_x <= s1_pos_x_comb;
    s1_pos_y <= s1_pos_y_comb;
    s1_pos_z <= s1_pos_z_comb;
    s1_dir_x <= s1_dir_x_comb;
    s1_dir_y <= s1_dir_y_comb;
    s1_dir_z <= s1_dir_z_comb;
    s1_is_new_ray <= s1_is_new_ray_comb;
    s1_valid  <= s1_is_new_ray_comb ? rg_valid   : d1_valid;
    s1_iter   <= d1_iter;
    s1_pix_id <= s1_is_new_ray_comb ? rg_pix_id  : d1_pix_id;
end

repeat_mod_cell inst_repeat_scene_x(
    .clk(clk),
    .p(s1_pos_x),
    .cell_sz(scene_cell_sz),
    .half_cell(scene_half_cell),
    .q(s1_scene_pos_x)
);

repeat_mod_cell inst_repeat_scene_y(
    .clk(clk),
    .p(s1_pos_y),
    .cell_sz(scene_cell_sz),
    .half_cell(scene_half_cell),
    .q(s1_scene_pos_y)
);

repeat_mod_cell inst_repeat_scene_z(
    .clk(clk),
    .p(s1_pos_z),
    .cell_sz(scene_cell_sz),
    .half_cell(scene_half_cell),
    .q(s1_scene_pos_z)
);

logic [26:0] sdf_dist;

scaffold_sdf inst1_scene_sdf(
    .clk(clk),
    .px(s1_scene_pos_x),
    .py(s1_scene_pos_y),
    .pz(s1_scene_pos_z),
    .shape_size(scene_shape_size),
    .shape_extra(scene_shape_extra),
    .sdf_out(sdf_dist)
);

logic [26:0] d2_pos_x;
logic [26:0] d2_pos_y;
logic [26:0] d2_pos_z;
logic [26:0] d2_dir_x;
logic [26:0] d2_dir_y;
logic [26:0] d2_dir_z;
logic [7:0]  d2_iter;
logic [19:0] d2_pix_id;
logic        d2_valid;

state_pipe #(.WIDTH(27), .DEPTH(SCENE_CORE_LAT)) inst1_d2_pos_x(.clk(clk), .in(s1_scene_pos_x), .out(d2_pos_x));
state_pipe #(.WIDTH(27), .DEPTH(SCENE_CORE_LAT)) inst1_d2_pos_y(.clk(clk), .in(s1_scene_pos_y), .out(d2_pos_y));
state_pipe #(.WIDTH(27), .DEPTH(SCENE_CORE_LAT)) inst1_d2_pos_z(.clk(clk), .in(s1_scene_pos_z), .out(d2_pos_z));
state_pipe #(.WIDTH(27), .DEPTH(SDF_LAT)) inst1_d2_dir_x(.clk(clk), .in(s1_dir_x), .out(d2_dir_x));
state_pipe #(.WIDTH(27), .DEPTH(SDF_LAT)) inst1_d2_dir_y(.clk(clk), .in(s1_dir_y), .out(d2_dir_y));
state_pipe #(.WIDTH(27), .DEPTH(SDF_LAT)) inst1_d2_dir_z(.clk(clk), .in(s1_dir_z), .out(d2_dir_z));
state_pipe #(.WIDTH(8),  .DEPTH(SDF_LAT)) inst1_d2_iter(.clk(clk), .in(s1_iter), .out(d2_iter));
state_pipe #(.WIDTH(20), .DEPTH(SDF_LAT)) inst1_d2_pix_id(.clk(clk), .in(s1_pix_id), .out(d2_pix_id));
state_pipe #(.WIDTH(1),  .DEPTH(SDF_LAT)) inst1_d2_valid(.clk(clk), .in(s1_valid), .out(d2_valid));

logic [26:0] step_x;
logic [26:0] step_y;
logic [26:0] step_z;

fp_mul inst1_mul_x(.clk(clk), .a(sdf_dist), .b(d2_dir_x), .out(step_x));
fp_mul inst1_mul_y(.clk(clk), .a(sdf_dist), .b(d2_dir_y), .out(step_y));
fp_mul inst1_mul_z(.clk(clk), .a(sdf_dist), .b(d2_dir_z), .out(step_z));

logic [26:0] new_pos_x;
logic [26:0] new_pos_y;
logic [26:0] new_pos_z;
logic [26:0] d2_pos_x_d;
logic [26:0] d2_pos_y_d;
logic [26:0] d2_pos_z_d;

state_pipe #(.WIDTH(27), .DEPTH(4)) inst1_d2_pos_x_d(.clk(clk), .in(d2_pos_x), .out(d2_pos_x_d));
state_pipe #(.WIDTH(27), .DEPTH(4)) inst1_d2_pos_y_d(.clk(clk), .in(d2_pos_y), .out(d2_pos_y_d));
state_pipe #(.WIDTH(27), .DEPTH(4)) inst1_d2_pos_z_d(.clk(clk), .in(d2_pos_z), .out(d2_pos_z_d));

fp_add inst1_add_x(.clk(clk), .a(d2_pos_x_d), .b(step_x), .out(new_pos_x));
fp_add inst1_add_y(.clk(clk), .a(d2_pos_y_d), .b(step_y), .out(new_pos_y));
fp_add inst1_add_z(.clk(clk), .a(d2_pos_z_d), .b(step_z), .out(new_pos_z));

logic [26:0] d3_dir_x;
logic [26:0] d3_dir_y;
logic [26:0] d3_dir_z;
logic [26:0] d3_dist;
logic [7:0]  d3_iter;
logic [19:0] d3_pix_id;
logic        d3_valid;

state_pipe #(.WIDTH(27), .DEPTH(STEP_LAT)) inst_d3_dir_x(.clk(clk), .in(d2_dir_x), .out(d3_dir_x));
state_pipe #(.WIDTH(27), .DEPTH(STEP_LAT)) inst_d3_dir_y(.clk(clk), .in(d2_dir_y), .out(d3_dir_y));
state_pipe #(.WIDTH(27), .DEPTH(STEP_LAT)) inst_d3_dir_z(.clk(clk), .in(d2_dir_z), .out(d3_dir_z));
state_pipe #(.WIDTH(27), .DEPTH(STEP_LAT)) inst_d3_dist(.clk(clk), .in(sdf_dist), .out(d3_dist));
state_pipe #(.WIDTH(8),  .DEPTH(STEP_LAT)) inst_d3_iter(.clk(clk), .in(d2_iter), .out(d3_iter));
state_pipe #(.WIDTH(20), .DEPTH(STEP_LAT)) inst_d3_pid(.clk(clk), .in(d2_pix_id), .out(d3_pix_id));
state_pipe #(.WIDTH(1),  .DEPTH(STEP_LAT)) inst_d3_valid(.clk(clk), .in(d2_valid), .out(d3_valid));

wire hit_comb  = d3_valid & (d3_dist[26] | (d3_dist < HIT_THRESH));
wire miss_comb = d3_valid & (d3_iter >= MAX_ITER);
wire done_comb = hit_comb | miss_comb;

//register all outputs breaks d3_dist comparator to BRAM WEA combinatorial path
always_ff @(posedge clk) begin
    pix_done    <= d3_valid & done_comb;
    fb_pix_id   <= d3_pix_id;
    fb_pos_x    <= new_pos_x;
    fb_pos_y    <= new_pos_y;
    fb_pos_z    <= new_pos_z;
    fb_ray_dir_x <= d3_dir_x;
    fb_ray_dir_y <= d3_dir_y;
    fb_ray_dir_z <= d3_dir_z;
    fb_iter     <= d3_iter + 8'd1;
    fb_valid    <= d3_valid & ~done_comb;
    out_pix_id  <= d3_pix_id;
    out_iter    <= d3_iter;
end

endmodule
