thapala2301/SummerProjectMathsAccelerator/RTL/video/ddr_rgb_writer.sv

/*
A complicated module, AXI handshake not easy..
Take completed pixels from march_core, writes them to DDR3 via AXI4
inputs: AXI4 transaction signals; if pixel is done (marched fully, ready to send to VDMA) pix_done, the id of px out_pix_id, iter_count, render_bank (which frame rendered to)
Outputs: AXI4 transaction signals, data on pixel to send to VDMA

Know: AXI4:
PRODUCER : asserts valid
CONSUMER : asserts ready

The module axi_fb_writer is master, it initiates all transactions. DDR3 is slave
AW : module producer, DDR3 consumer (master sends adr+burst info)
W : module producer, DDR3 consumer (master sends data + strb)
B : DDR3 producer, module consumer (slave is sending back)
*/

module ddr_rgb_writer #(
    parameter int FIFO_DEPTH = 4096,
    parameter int FIFO_ALMOST_FULL = FIFO_DEPTH - 512, //by the time FIFO_FULL asserts and stall propagates back to stop pix dispatch, there are alr pix deep in march core pipeline that have not hit fifo yet
    //the pipeline is very long, those in flight pix overflow full FIFO
    //Alm full fires 512 entries early, giving enough headroom to absorb everything alr in flight before FIFO acc fills up
    //512, bc it's at least as large as total pipe depth, ie the nb of pix that can be in flight inside march core at any time when stall fires
    parameter int MAX_OUTSTANDING = 8, //each outstanding write needs DDR controller to track response
    //too many in flight and the DDR controller queus fill up, get stalls anyway. 
    parameter SCREEN_WIDTH = 512,
    parameter SCREEN_HEIGHT = 300
) (
    input  logic        clk,
    input  logic        rst,
    input  logic [31:0] frame_base_0,
    input  logic [31:0] frame_base_1,
    input  logic [23:0] bg_rgb,
    input  logic [23:0] shape_rgb,
    input  logic        pix_done,
    input  logic [19:0] out_pix_id,
    input  logic [7:0]  out_iter,
    input  logic        render_bank,
    output logic        fifo_almost_full,
    output logic        drained,
    //outupt axi4 write master AW chan, W chan, B chan DDR3 controller
    //AW Chan - Address Write
    output logic [31:0] m_axi_awaddr,
    output logic [3:0]  m_axi_awlen,
    output logic [2:0]  m_axi_awsize,
    output logic [1:0]  m_axi_awburst,
    output logic [3:0]  m_axi_awcache,
    output logic [2:0]  m_axi_awprot,
    output logic        m_axi_awvalid, //producer side - march_core
    input  logic        m_axi_awready,  //consumer side - DDR
    //W Chan
    output logic [63:0] m_axi_wdata,
    output logic [7:0]  m_axi_wstrb,
    output logic        m_axi_wlast,
    output logic        m_axi_wvalid, //producer side - march_core
    input  logic        m_axi_wready, //consumer side - DDR
    //B Chan
    input  logic [1:0]  m_axi_bresp,
    input  logic        m_axi_bvalid, //producer side - DDR
    output logic        m_axi_bready // consumer side - march_core
);

    localparam int ENTRY_W = 45; //how big one entry of the fifo is
    localparam logic [19:0] FRAME_RAY_COUNT = SCREEN_WIDTH * SCREEN_HEIGHT; //dispatch generates that many px for grid
    localparam int OUTSTANDING_W = (MAX_OUTSTANDING <= 1) ? 1 : $clog2(MAX_OUTSTANDING + 1); //number of bits needed to count up to max outstanding
    //need a reg to hold outstanding_count: how many AXI writes are currently in flight, sent but not acknowledged.
    //counter goes from 0 to MAX_OUTSTANDING

    /*
    one raymarched pixel → 2×2 block on display
                     → 8 bytes written at addr       (row N,   cols 2c and 2c+1)
                     → 8 bytes written at addr+4096  (row N+1, cols 2c and 2c+1)

    computes DDR write adr for one px. Unpacks render_bank and pix_id from fifo entry, picks base0 or 1 then does
    base + (pix_id[19:9] << 13) + (pix_id[8:0] << 3): that's base + pix_id*8 written in two shifts. Each px takes 8 bytes

    pix_id = row*512+col
    to recover row and col from pix id: row = pix_id / 512 = pix_id >> 9
    col = pix_id % 512 = pix_id[8:0]
    as 512 = 2^9
    */
    function automatic logic [31:0] entry_addr_top(input logic [ENTRY_W-1:0] entry);
        logic [31:0] base_addr;
        logic [19:0] pix_id;
        begin
            base_addr = entry[44] ? frame_base_1 : frame_base_0;
            pix_id = entry[43:24];
            entry_addr_top = base_addr + {8'd0, pix_id[19:9], 13'b0} + {20'd0, pix_id[8:0], 3'b0};
        end
    endfunction

    //computes 64 bit data to write: packs 24 bit RBG into two 32 bit words , then writes same px color twice in one 64 bit beat
    //bc each AXI write coverts two adjacenet px in frame buffer: stereo: left and right px of same row share same color
    function automatic logic [63:0] entry_data64(input logic [ENTRY_W-1:0] entry);
        begin
            entry_data64 = {{8'h00, entry[23:0]}, {8'h00, entry[23:0]}};
        end
    endfunction

    logic        rst_n;
    logic [23:0] rgb_col;
    logic        pix_done_d1;
    logic        pix_done_d2;
    logic [19:0] pix_id_d1;
    logic [19:0] pix_id_d2;
    logic        render_bank_d1;
    logic        render_bank_d2;
    logic        frame_base_valid_d;
    logic        fifo_wr_en;
    logic        fifo_rd_en;
    logic [ENTRY_W-1:0] fifo_wr_data;
    logic [ENTRY_W-1:0] fifo_rd_data;
    logic        fifo_full;
    logic        fifo_empty;
    logic        active_entry_valid;
    logic [ENTRY_W-1:0] active_entry;
    logic        prefetched_entry_valid;
    logic [ENTRY_W-1:0] prefetched_entry;

    logic        write_row1;
    logic        beat_valid;
    logic [31:0] beat_addr;
    logic [63:0] beat_data;
    logic        aw_sent;
    logic        w_sent;
    logic [OUTSTANDING_W-1:0] outstanding_count;

    logic [31:0] active_addr0;
    logic [31:0] active_addr1;
    logic [63:0] active_data64;

    logic        aw_fire;
    logic        w_fire;
    logic        aw_sent_next;
    logic        w_sent_next;
    logic        beat_done_now;
    logic        b_handshake;
    logic [OUTSTANDING_W-1:0] outstanding_count_next;
    logic        beat_slot_free;
    logic        outstanding_available;
    logic        load_active_from_fifo;
    logic        load_prefetch_from_fifo;
    logic        can_issue_beat;
    logic        finish_entry_now;

    assign rst_n = ~rst;

    palette inst_palette(
        .clk(clk),
        .rst_n(rst_n),
        .iter(out_iter),
        .bg_rgb(bg_rgb),
        .shape_rgb(shape_rgb),
        .rgb(rgb_col)
    );

    always_ff @(posedge clk) begin
        if (rst) begin
            pix_done_d1 <= 1'b0;
            pix_done_d2 <= 1'b0;
            pix_id_d1 <= '0;
            pix_id_d2 <= '0;
            render_bank_d1 <= 1'b0;
            render_bank_d2 <= 1'b0;
            frame_base_valid_d <= 1'b0;
        end else begin
            pix_done_d1 <= pix_done;
            pix_done_d2 <= pix_done_d1;
            pix_id_d1 <= out_pix_id;
            pix_id_d2 <= pix_id_d1;
            render_bank_d1 <= render_bank;
            render_bank_d2 <= render_bank_d1;
            frame_base_valid_d <= (frame_base_0 != 32'd0) && (frame_base_1 != 32'd0);
        end
    end

    assign fifo_wr_en = pix_done_d2 & (pix_id_d2 < FRAME_RAY_COUNT) & frame_base_valid_d;
    assign fifo_wr_data = {render_bank_d2, pix_id_d2, rgb_col};

    FIFO #(
        .WIDTH(ENTRY_W),
        .DEPTH(FIFO_DEPTH),
        .ALMOST_FULL_LEVEL(FIFO_ALMOST_FULL)
    ) inst_result_fifo (
        .clk(clk),
        .rst(rst),
        .wr_en(fifo_wr_en),
        .wr_data(fifo_wr_data),
        .rd_en(fifo_rd_en),
        .rd_data(fifo_rd_data),
        .FIFO_FULL(fifo_full),
        .FIFO_EMPTY(fifo_empty),
        .FIFO_ALMOST_FULL(fifo_almost_full)
    );

    assign active_addr0 = entry_addr_top(active_entry); //DDR adr for ray marched row
    assign active_addr1 = active_addr0 + 32'd4096; //same row + 4096 bytes: duplicate row below
    assign active_data64 = entry_data64(active_entry); //the 64 bit data to write at both adr

    assign m_axi_awaddr = beat_addr;
    assign m_axi_awlen = 4'd0;
    assign m_axi_awsize = 3'd3;
    assign m_axi_awburst = 2'b01;
    assign m_axi_awcache = 4'b0011;
    assign m_axi_awprot = 3'b000;
    assign m_axi_awvalid = beat_valid & ~aw_sent;
    assign m_axi_wdata = beat_data;
    assign m_axi_wstrb = 8'hFF;
    assign m_axi_wlast = 1'b1;
    assign m_axi_wvalid = beat_valid & ~w_sent;
    assign m_axi_bready = 1'b1;

    assign aw_fire = m_axi_awvalid & m_axi_awready;
    assign w_fire = m_axi_wvalid & m_axi_wready;
    assign aw_sent_next = aw_sent | aw_fire;
    assign w_sent_next = w_sent | w_fire;
    assign beat_done_now = beat_valid & aw_sent_next & w_sent_next;
    assign b_handshake = m_axi_bvalid & m_axi_bready;
    assign beat_slot_free = !beat_valid || beat_done_now;
    assign outstanding_available = outstanding_count_next < MAX_OUTSTANDING;
    assign load_active_from_fifo = !active_entry_valid && !fifo_empty;
    assign load_prefetch_from_fifo = active_entry_valid && !prefetched_entry_valid && !fifo_empty;
    //while beat 1 is being issued for current entry, prefetch grabs next FIFO entry in parallel. When curr entry finishes, after beat 2,
    //next one is alr loaded - no stall clk btw px
    assign can_issue_beat = beat_slot_free && outstanding_available && active_entry_valid;
    assign finish_entry_now = can_issue_beat && write_row1;
    assign fifo_rd_en = load_active_from_fifo || load_prefetch_from_fifo;
    assign drained = fifo_empty & ~active_entry_valid & ~prefetched_entry_valid & ~beat_valid &
                     (outstanding_count == '0) &
                     ~pix_done_d1 & ~pix_done_d2;

    always_comb begin
        outstanding_count_next = outstanding_count;

        if (b_handshake && (outstanding_count_next != '0)) begin
            outstanding_count_next = outstanding_count_next - 1'b1;
        end

        if (beat_done_now) begin
            outstanding_count_next = outstanding_count_next + 1'b1;
        end
    end

    always_ff @(posedge clk) begin
        if (rst) begin
            active_entry_valid <= 1'b0;
            active_entry <= '0;
            prefetched_entry_valid <= 1'b0;
            prefetched_entry <= '0;
            write_row1 <= 1'b0;
            beat_valid <= 1'b0;
            beat_addr <= '0;
            beat_data <= '0;
            aw_sent <= 1'b0;
            w_sent <= 1'b0;
            outstanding_count <= '0;
        end else begin
            outstanding_count <= outstanding_count_next;

            // Each FIFO result produces two writes: row0 then duplicated row1.
            if (load_active_from_fifo) begin
                active_entry <= fifo_rd_data;
                active_entry_valid <= 1'b1;
                write_row1 <= 1'b0;
            end

            if (load_prefetch_from_fifo && !finish_entry_now) begin
                prefetched_entry <= fifo_rd_data;
                prefetched_entry_valid <= 1'b1;
            end

            if (can_issue_beat) begin
                beat_valid <= 1'b1;
                beat_addr <= write_row1 ? active_addr1 : active_addr0;
                beat_data <= active_data64;
                aw_sent <= 1'b0;
                w_sent <= 1'b0;
                if (write_row1) begin
                    write_row1 <= 1'b0;
                    if (prefetched_entry_valid) begin
                        active_entry <= prefetched_entry;
                        active_entry_valid <= 1'b1;
                        prefetched_entry_valid <= 1'b0;
                    end else if (load_prefetch_from_fifo) begin
                        active_entry <= fifo_rd_data;
                        active_entry_valid <= 1'b1;
                    end else begin
                        active_entry_valid <= 1'b0;
                    end
                end else begin
                    write_row1 <= 1'b1;
                end
            end else if (beat_done_now) begin
                beat_valid <= 1'b0;
                aw_sent <= 1'b0;
                w_sent <= 1'b0;
            end else if (beat_valid) begin
                aw_sent <= aw_sent_next;
                w_sent <= w_sent_next;
            end
        end
    end

endmodule
