thapala2301/SummerProjectMathsAccelerator/Vincent/initial_attempts_FPGA_NeuralNetwork/learning_NeuralNetworkFPGA/full_NN/layer_1.v

module Layer_1 #(parameter NN = 30,numWeight=784,dataWidth=16,layerNum=1,sigmoidSize=10,weightIntWidth=4,actType="relu")
    (
    input           clk,
    input           rst,
    input           weightValid,
    input           biasValid,
    input [31:0]    weightValue,
    input [31:0]    biasValue,
    input [31:0]    config_layer_num,
    input [31:0]    config_neuron_num,
    input           x_valid,
    input [dataWidth-1:0]    x_in,
    output [NN-1:0]     o_valid,
    output [NN*dataWidth-1:0]  x_out //NN= number of neurons in neural layer. Flattening output from all neurons, obtaining a bus
    //flattening output to obtain bus
    );
neuron #(.numWeight(numWeight),.layerNo(layerNum),.neuronNo(0),.dataWidth(dataWidth),.sigmoidSize(sigmoidSize),.weightIntWidth(weightIntWidth),.actType(actType),.weightFile("w_1_0.mif"),.biasFile("b_1_0.mif"))n_0(
        .clk(clk),
        .rst(rst),
        .myinput(x_in),
        .weightValid(weightValid),
        .biasValid(biasValid),
        .weightValue(weightValue),
        .biasValue(biasValue),
        .config_layer_num(config_layer_num),
        .config_neuron_num(config_neuron_num),
        .myinputValid(x_valid),
        .out(x_out[0*dataWidth+:dataWidth]),
        .outvalid(o_valid[0])
        );
neuron #(.numWeight(numWeight),.layerNo(layerNum),.neuronNo(1),.dataWidth(dataWidth),.sigmoidSize(sigmoidSize),.weightIntWidth(weightIntWidth),.actType(actType),.weightFile("w_1_1.mif"),.biasFile("b_1_1.mif"))n_1(
        .clk(clk),
        .rst(rst),
        .myinput(x_in),
        .weightValid(weightValid),
        .biasValid(biasValid),
        .weightValue(weightValue),
        .biasValue(biasValue),
        .config_layer_num(config_layer_num),
        .config_neuron_num(config_neuron_num),
        .myinputValid(x_valid),
        .out(x_out[1*dataWidth+:dataWidth]),
        .outvalid(o_valid[1])
        );
neuron #(.numWeight(numWeight),.layerNo(layerNum),.neuronNo(2),.dataWidth(dataWidth),.sigmoidSize(sigmoidSize),.weightIntWidth(weightIntWidth),.actType(actType),.weightFile("w_1_2.mif"),.biasFile("b_1_2.mif"))n_2(
        .clk(clk),
        .rst(rst),
        .myinput(x_in),
        .weightValid(weightValid),
        .biasValid(biasValid),
        .weightValue(weightValue),
        .biasValue(biasValue),
        .config_layer_num(config_layer_num),
        .config_neuron_num(config_neuron_num),
        .myinputValid(x_valid),
        .out(x_out[2*dataWidth+:dataWidth]),
        .outvalid(o_valid[2])
        );
neuron #(.numWeight(numWeight),.layerNo(layerNum),.neuronNo(3),.dataWidth(dataWidth),.sigmoidSize(sigmoidSize),.weightIntWidth(weightIntWidth),.actType(actType),.weightFile("w_1_3.mif"),.biasFile("b_1_3.mif"))n_3(
        .clk(clk),
        .rst(rst),
        .myinput(x_in),
        .weightValid(weightValid),
        .biasValid(biasValid),
        .weightValue(weightValue),
        .biasValue(biasValue),
        .config_layer_num(config_layer_num),
        .config_neuron_num(config_neuron_num),
        .myinputValid(x_valid),
        .out(x_out[3*dataWidth+:dataWidth]),
        .outvalid(o_valid[3])
        );
neuron #(.numWeight(numWeight),.layerNo(layerNum),.neuronNo(4),.dataWidth(dataWidth),.sigmoidSize(sigmoidSize),.weightIntWidth(weightIntWidth),.actType(actType),.weightFile("w_1_4.mif"),.biasFile("b_1_4.mif"))n_4(
        .clk(clk),
        .rst(rst),
        .myinput(x_in),
        .weightValid(weightValid),
        .biasValid(biasValid),
        .weightValue(weightValue),
        .biasValue(biasValue),
        .config_layer_num(config_layer_num),
        .config_neuron_num(config_neuron_num),
        .myinputValid(x_valid),
        .out(x_out[4*dataWidth+:dataWidth]),
        .outvalid(o_valid[4])
        );
neuron #(.numWeight(numWeight),.layerNo(layerNum),.neuronNo(5),.dataWidth(dataWidth),.sigmoidSize(sigmoidSize),.weightIntWidth(weightIntWidth),.actType(actType),.weightFile("w_1_5.mif"),.biasFile("b_1_5.mif"))n_5(
        .clk(clk),
        .rst(rst),
        .myinput(x_in),
        .weightValid(weightValid),
        .biasValid(biasValid),
        .weightValue(weightValue),
        .biasValue(biasValue),
        .config_layer_num(config_layer_num),
        .config_neuron_num(config_neuron_num),
        .myinputValid(x_valid),
        .out(x_out[5*dataWidth+:dataWidth]),
        .outvalid(o_valid[5])
        );
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
        .clk(clk),
        .rst(rst),
        .myinput(x_in),
        .weightValid(weightValid),
        .biasValid(biasValid),
        .weightValue(weightValue),
        .biasValue(biasValue),
        .config_layer_num(config_layer_num),
        .config_neuron_num(config_neuron_num),
        .myinputValid(x_valid),
        .out(x_out[27*dataWidth+:dataWidth]),
        .outvalid(o_valid[27])
        );
neuron #(.numWeight(numWeight),.layerNo(layerNum),.neuronNo(28),.dataWidth(dataWidth),.sigmoidSize(sigmoidSize),.weightIntWidth(weightIntWidth),.actType(actType),.weightFile("w_1_28.mif"),.biasFile("b_1_28.mif"))n_28(
        .clk(clk),
        .rst(rst),
        .myinput(x_in),
        .weightValid(weightValid),
        .biasValid(biasValid),
        .weightValue(weightValue),
        .biasValue(biasValue),
        .config_layer_num(config_layer_num),
        .config_neuron_num(config_neuron_num),
        .myinputValid(x_valid),
        .out(x_out[28*dataWidth+:dataWidth]),
        .outvalid(o_valid[28])
        );
neuron #(.numWeight(numWeight),.layerNo(layerNum),.neuronNo(29),.dataWidth(dataWidth),.sigmoidSize(sigmoidSize),.weightIntWidth(weightIntWidth),.actType(actType),.weightFile("w_1_29.mif"),.biasFile("b_1_29.mif"))n_29(
        .clk(clk),
        .rst(rst),
        .myinput(x_in),
        .weightValid(weightValid),
        .biasValid(biasValid),
        .weightValue(weightValue),
        .biasValue(biasValue),
        .config_layer_num(config_layer_num),
        .config_neuron_num(config_neuron_num),
        .myinputValid(x_valid),
        .out(x_out[29*dataWidth+:dataWidth]),
        .outvalid(o_valid[29])
        );
endmodule
