thapala2301/SummerProjectMathsAccelerator/ip_repo/axi_camera_regs_ip_1_0/src/fp_length.v

//computes sqrt(x^2+y^2+z^2): length of vector/norm
//use that sqrtx = isqrtx * x, only need fp_mull on top of isqrt
//true sqrtx from newton raphson requires division, far too expensive.
//total clk: 22
module fp_length(
    input clk,
    input wire [26:0] x,
    input wire [26:0] y,
    input wire [26:0] z,
    output wire [26:0] out
);
wire [26:0] x2, y2, z2, z2_delayed, tempadd_x2_y2, sum_x2_y2_z2, isqrt_sum, sqrt_sum, sum_delayed;


//fp_mul=4, fp_add=4, fp_isqrt=16
//cycle 0:  x,y,z in
//cycle 4:  x2,y2,z2 ready
//cycle 8:  x2+y2 ready; z2_delayed arrives (DEPTH=4)
//cycle 12: sum = x2+y2+z2 ready
//cycle 28: isqrt(sum) ready (fp_isqrt=16)
//sum_delayed DEPTH=16 so it arrives at cycle 28 alongside isqrt
//Cycle 32: sqrt_sum = isqrt * sum ready (fp_mul=4)
fp_mul mul_x_x (.clk(clk), .a(x), .b(x), .out(x2));
fp_mul mul_y_y (.clk(clk), .a(y), .b(y), .out(y2));
fp_mul mul_z_z (.clk(clk), .a(z), .b(z), .out(z2));
fp_add add_x2_y2 (.clk(clk), .a(x2), .b(y2), .out(tempadd_x2_y2));
state_pipe #(.WIDTH(27), .DEPTH(4)) pipe_z2(.clk(clk), .in(z2), .out(z2_delayed));
fp_add add_tempx2y2_z2(.clk(clk), .a(tempadd_x2_y2), .b(z2_delayed), .out(sum_x2_y2_z2));
state_pipe #(.WIDTH(27), .DEPTH(16)) pipe_sum(.clk(clk), .in(sum_x2_y2_z2), .out(sum_delayed));
fp_isqrt inst_isqrt_sum(.clk(clk), .a(sum_x2_y2_z2), .out(isqrt_sum));
fp_mul mul_final (.clk(clk), .a(isqrt_sum), .b(sum_delayed), .out(sqrt_sum));

assign out = sqrt_sum;



endmodule
