thapala2301/SummerProjectMathsAccelerator/Vincent/initial_attempts_FPGA_NeuralNetwork/learning_NeuralNetworkFPGA/ReLu.v

module ReLu # (parameter dataWidth = 16, weightIntWidth = 4) (
    input clk,
    input [2*dataWidth-1:0] sum,
    output reg [dataWidth-1:0] out
);

always @ (posedge clk)
begin
    if($signed(x)>=0)
    begin
        if(x[2*dataWidth-1-:weightIntWidth+1]) //overflow to sign bit of int part 
            out <= {1'b0, {(dataWidth-1){1'b1}}}; //oversaturate
        else 
            out <= x[2*dataWidth-1-weightIntWidth-:dataWidth];
    end
    else
        out <= 0;
end


endmodule
