thapala2301/SummerProjectMathsAccelerator/Vincent/initial_attempts_FPGA_NeuralNetwork/learning_NeuralNetworkFPGA/Sig_ROM.v

module Sig_ROM #(parameter inWidth = 10, dataWidth = 16)
(
    input clk,
    input [inWidth-1:0] x,
    output [dataWidth-1:0] out
);

    reg [dataWidth-1:0] mem [2**inWidth-1:0]; //generate all 2*10 combinations of values
    reg [inWidth-1:0] y;
    initial
    begin
        $readmemb("SigContent.mif", mem); //mif is memory file
    end

    always @ (posedge clk) begin
        if($signed (x )>=0)
            y <= x+(2**(inWidth-1));
        else 
            y <= x-(2**(inWidth-1));
    end
    assign out = mem[y];



endmodule
