thapala2301/SummerProjectMathsAccelerator/SIM_testbenches/tb_mandelbox_ppm_main.cpp

// Verilator testbench: mandelbox scene_sdf -> PPM slice
// Renders a 256x256 XY slice at z=-2, world coords [-3,3]x[-3,3]
// Also runs spot checks on known SDF properties.
//
// Build & run: make mandelbox_ppm   (from SIM/)
// Output: mandelbox_rtl.ppm

#include "Vmandelbox_ppm_top.h"
#include "verilated.h"
#include <cmath>
#include <cstdint>
#include <cstdio>
#include <cstring>
#include <vector>
#include <fstream>

// -----------------------------------------------------------------------
// FP27 <-> float
// -----------------------------------------------------------------------
static uint32_t f2fp27(float f) {
    if (f == 0.0f) return 0;
    uint32_t b; memcpy(&b, &f, 4);
    uint32_t sign = (b >> 31) & 1;
    uint32_t exp  = (b >> 23) & 0xFF;
    uint32_t mant = (b & 0x7FFFFF) >> 5;
    return (sign << 26) | (exp << 18) | mant;
}

static float fp272f(uint32_t v) {
    uint32_t exp = (v >> 18) & 0xFF;
    if (exp == 0) return 0.0f;
    uint32_t sign = (v >> 26) & 1;
    uint32_t mant = (v & 0x3FFFF) << 5;
    uint32_t b = (sign << 31) | (exp << 23) | mant;
    float f; memcpy(&f, &b, 4);
    return f;
}

static void tick(Vmandelbox_ppm_top* top) {
    top->clk = 0; top->eval();
    Verilated::timeInc(1);
    top->clk = 1; top->eval();
    Verilated::timeInc(1);
}

// -----------------------------------------------------------------------
// Spot check helpers
// -----------------------------------------------------------------------
static int g_fails = 0;

static void check(const char* label, float got, float expected, float tol) {
    float err = std::fabs(got - expected);
    if (err <= tol)
        std::printf("  PASS  %-38s = %+.4f (expected %+.4f)\n", label, got, expected);
    else {
        std::printf("  FAIL  %-38s = %+.4f (expected %+.4f, err %.4f)\n",
                    label, got, expected, err);
        g_fails++;
    }
}

static void check_sign(const char* label, float got, bool expect_negative) {
    bool is_neg = got < 0.0f;
    if (is_neg == expect_negative)
        std::printf("  PASS  %-38s = %+.4f (%s)\n", label, got,
                    expect_negative ? "inside (neg)" : "outside (pos)");
    else {
        std::printf("  FAIL  %-38s = %+.4f (expected %s)\n", label, got,
                    expect_negative ? "negative/inside" : "positive/outside");
        g_fails++;
    }
}

static void check_range(const char* label, float got, float lo, float hi) {
    if (got >= lo && got <= hi)
        std::printf("  PASS  %-38s = %+.4f (in [%.3f, %.3f])\n", label, got, lo, hi);
    else {
        std::printf("  FAIL  %-38s = %+.4f (expected in [%.3f, %.3f])\n", label, got, lo, hi);
        g_fails++;
    }
}

// -----------------------------------------------------------------------
// Pipeline runner — same streaming model as Menger testbench
// fp_length takes 32 cycles (not 22 as the module comment claims):
//   x^2/y^2/z^2 (4) + add x2y2 (4) + add z2 (4) + isqrt (16) + mul (4) = 32.
// True SCENE_CORE_LAT = 197 (iter4 out) + 32 (fp_length) + 4 (fp_mul*0.05)
//                      + 1 (sdf_out reg) = 234, not 224 as commented.
// Verilator PL = RTL latency - 1 = 234 - 1 = 233.
// -----------------------------------------------------------------------
static constexpr int PIPELINE_LAT = 233;

static std::vector<float> run_pipeline(
    Vmandelbox_ppm_top* top,
    const std::vector<std::tuple<float,float,float>>& pts)
{
    int N = (int)pts.size();
    std::vector<float> out(N, 0.0f);

    for (int cycle = 0; cycle < N + PIPELINE_LAT + 2; ++cycle) {
        int in_i = cycle;
        if (in_i < N) {
            auto [x,y,z] = pts[in_i];
            top->px = f2fp27(x);
            top->py = f2fp27(y);
            top->pz = f2fp27(z);
        } else {
            top->px = top->py = top->pz = 0;
        }

        tick(top);

        int out_i = cycle - PIPELINE_LAT;
        if (out_i >= 0 && out_i < N)
            out[out_i] = fp272f(top->sdf_out);
    }

    return out;
}

// -----------------------------------------------------------------------
// Spot checks
// The mandelbox SDF is not analytically simple, so we check:
//   - Far outside bounding sphere (r >> 3): SDF positive, dominated by bound_d
//   - Well inside bounding sphere, close to fractal surface: SDF small/negative
// We rely on sign checks rather than exact values.
// -----------------------------------------------------------------------
static void run_spot_checks(Vmandelbox_ppm_top* top) {
    std::printf("\n--- Spot checks ---\n");

    struct Case { float x,y,z; bool expect_neg; const char* label; };
    Case cases[] = {
        // Far outside bounding sphere (r=10 >> 3): SDF >> 0
        { 10.0f, 0.0f, 0.0f,  false, "outside sphere (10,0,0)" },
        { 0.0f, 10.0f, 0.0f,  false, "outside sphere (0,10,0)" },

        // Origin: z=(0,0,0), box/sphere folds of 0 are 0, z4=(0,0,0), length=0, SDF=0.
        // Mandelbox SDF is always >= 0 (conservative distance estimate, not exact signed distance).
        { 0.0f,  0.0f, 0.0f,  false, "origin (0,0,0) - on fractal surface (SDF=0)" },

        // On the bounding sphere boundary (r=3): SDF near 0 from bounding sphere term
        { 3.0f,  0.0f, 0.0f,  false, "on bounding sphere (3,0,0)" },
    };

    std::vector<std::tuple<float,float,float>> pts;
    for (auto& c : cases) pts.emplace_back(c.x, c.y, c.z);
    auto out = run_pipeline(top, pts);

    for (int i = 0; i < (int)(sizeof(cases)/sizeof(cases[0])); ++i)
        check_sign(cases[i].label, out[i], cases[i].expect_neg);
}

// -----------------------------------------------------------------------
// Inside-sphere spot checks
// Mandelbox SDF inside bounding sphere (|p|<3) = length(z4)*0.05.
// For orbits that stay bounded, z4 is O(1) so SDF < ~0.5.
// Verifies the 4-iteration orbit pipeline isn't blowing up for interior points.
// Expected ranges are loose — the goal is to confirm non-absurd values,
// not match a CPU reference (use tools/mandelbox_ppm.py for that).
// -----------------------------------------------------------------------
static void run_inside_checks(Vmandelbox_ppm_top* top) {
    std::printf("\n--- Inside-sphere checks (orbit bounded => SDF small) ---\n");

    struct Case { float x,y,z; float lo, hi; const char* label; };
    Case cases[] = {
        // Origin: z4=(0,0,0), SDF=0 exactly (degenerate, but pipeline handles it)
        { 0.0f,  0.0f,  0.0f,  0.0f, 0.01f, "origin (SDF=0 exact)" },

        // (0,0,-1): |p|=1 < 3, inside sphere. Orbit converges near fractal -> SDF small
        { 0.0f,  0.0f, -1.0f,  0.0f, 0.5f,  "inside sphere (0,0,-1)" },

        // (1,0,-1): |p|=sqrt(2) < 3. Inside sphere, near fractal region
        { 1.0f,  0.0f, -1.0f,  0.0f, 0.8f,  "inside sphere (1,0,-1)" },

        // (0,0,-2): center of PPM slice. SDF in [dmin, dmax] observed = [0.10, 1.69]
        { 0.0f,  0.0f, -2.0f,  0.0f, 1.7f,  "PPM center slice (0,0,-2)" },

        // (2.5,0,0): near bounding sphere equator (|p|=2.5 < 3). SDF = max(fractal_d, -0.5)
        // Since fractal_d >= 0, SDF = fractal_d, should be small-ish but positive
        { 2.5f,  0.0f,  0.0f,  0.0f, 2.0f,  "near bounding sphere (2.5,0,0)" },
    };

    std::vector<std::tuple<float,float,float>> pts;
    for (auto& c : cases) pts.emplace_back(c.x, c.y, c.z);
    auto out = run_pipeline(top, pts);

    for (int i = 0; i < (int)(sizeof(cases)/sizeof(cases[0])); ++i)
        check_range(cases[i].label, out[i], cases[i].lo, cases[i].hi);
}

// -----------------------------------------------------------------------
// PPM: 256x256 XY slice at z=-2 over [-3,3]x[-3,3]
// z=-2 cuts through the mandelbox interior nicely for scale=-1.5
// -----------------------------------------------------------------------
static void write_ppm(Vmandelbox_ppm_top* top) {
    constexpr int W = 256, H = 256;
    constexpr float X0 = -3.0f, X1 = 3.0f;
    constexpr float Y0 = -3.0f, Y1 = 3.0f;
    constexpr float Z  = -2.0f;

    std::vector<std::tuple<float,float,float>> pts;
    pts.reserve(W * H);
    for (int row = 0; row < H; ++row)
        for (int col = 0; col < W; ++col)
            pts.emplace_back(
                X0 + (X1-X0) * col / (W-1),
                Y1 - (Y1-Y0) * row / (H-1),
                Z);

    std::printf("Running pipeline for %dx%d pixels (%d cycles)...\n",
                W, H, W*H + PIPELINE_LAT + 2);
    auto sdf = run_pipeline(top, pts);

    float dmin = sdf[0], dmax = sdf[0];
    for (float v : sdf) { dmin = std::min(dmin, v); dmax = std::max(dmax, v); }
    std::printf("SDF range: [%.4f, %.4f]\n", dmin, dmax);

    std::vector<uint8_t> img(W * H * 3);
    for (int i = 0; i < W*H; ++i) {
        float d = sdf[i];
        uint8_t r, g, b;
        if (d < 0.0f) {
            // Inside fractal: dark blue-grey
            uint8_t v = (uint8_t)(20 + std::min(1.0f, -d * 8.0f) * 80);
            r = v; g = v; b = (uint8_t)(v + 30);
        } else if (d < 0.3f) {
            // Near surface: white-hot
            float t = d / 0.3f;
            r = 255; g = (uint8_t)(255 * (1.0f-t*t)); b = (uint8_t)(200 * (1.0f-t));
        } else {
            // Far outside: black
            r = 0; g = 0; b = 0;
        }
        img[i*3+0] = r; img[i*3+1] = g; img[i*3+2] = b;
    }

    std::ofstream f("mandelbox_rtl.ppm", std::ios::binary);
    f << "P6\n" << W << " " << H << "\n255\n";
    f.write(reinterpret_cast<const char*>(img.data()), img.size());
    std::printf("Wrote mandelbox_rtl.ppm (%dx%d)\n", W, H);
}

int main(int argc, char** argv) {
    Verilated::commandArgs(argc, argv);
    auto* top = new Vmandelbox_ppm_top;

    // Flush the full 234-stage pipeline
    top->clk = 0; top->px = top->py = top->pz = 0;
    for (int i = 0; i < 240; ++i) tick(top);

    run_spot_checks(top);
    run_inside_checks(top);
    write_ppm(top);

    top->final();
    delete top;

    std::printf("\n%s (%d failures)\n", g_fails ? "FAIL" : "PASS", g_fails);
    return g_fails ? 1 : 0;
}
