thapala2301/SummerProjectMathsAccelerator/(commit log)

2026-05-28 All sv files checked and all testbenches fixed (introducing the negedge) . run_tests.bat can be used to check all tests are passing.
    [feedback_ctrl.sv]
2026-05-29 Format switch to Q1.8.18
2026-05-31 lib plumbing
    [PmodDHB1_MotorFeedback_0_0.xml]
2026-05-31 raygen, camera regs and fp ops testbenches
2026-06-03 scrapped all the neural stuff, didn't underestand, back to square 1
    [neuron.sv, neuron_ReLu.sv, sdf_nn.sv]
2026-06-06 merged hdmi with main
    [PmodDHB1_MotorFeedback_0_0.xml]
2026-06-08 multicore and vdma vivado project
    [PmodDHB1_MotorFeedback_0_0.xml]
2026-06-10 fog, color based fog, full mod working, need to fix floor for negative FP
    [FIFO.sv, feedback_ctrl.sv, march_core.sv, palette.sv, ray_marcher_top.v, scene_sdf.v]
2026-06-10 Add camera versions
2026-06-10 started integration of music and camera to core
2026-06-12 Refactor board.py for clarity and functionality
2026-06-12 WORKING UI CELEBRATION YOOOOYOOHHOOO just need to fix screen offset
    [board.py, camera_mmio_controller.py, ctrl.py]
2026-06-28 final version
    [BodyAdapted.SLDASM, PmodDHB1_MotorFeedback_0_0.xml, Quest 3 Head band adapter v5.SLDPRT, Quest2Adapter.SLDPRT, body.SLDPRT, eyes_panel.SLDPRT, foam_support.SLDPRT, front_panel.SLDPRT]
